helu33/25-aiming-cart/docs/CHASSIS_SCHEME.md

# 底盘方案（2025 电赛 E 题，正方形巡线）

本文是开发前写的底盘设计方案，记录设计思路和取舍。底盘负责巡线、过弯、计圈和停车，并把运动状态发给云台。实现时不少细节改了（例如直道加了陀螺航向保持、丢线不做原地搜索、参数都按实车重新标定），**现行实现、参数和接线以 [chassis/AUTONOMOUS_CHASSIS.md](../chassis/AUTONOMOUS_CHASSIS.md) 和源码为准**。云台和 K230 视觉见 [GIMBAL_COMM_PROTOCOL.md](GIMBAL_COMM_PROTOCOL.md) 和 [K230_VISION_SCHEME.md](K230_VISION_SCHEME.md)。

底盘用 STM32F103，代码基础是作者自己的 ROS 2 小车固件，沿用其中的 8 路选通式巡线模块、电机、车轮和编码器；没有按赛题要求移植到 TI MSPM0。硬件层与控制层分离，控制层可以在电脑上测试。

## 0. 赛题约束

赛题摘录，完整条款以原题为准。本项目用 STM32 代替 MSPM0，不满足「控制器」一条。

来源：[2025 年 E 题 简易自行瞄准装置](https://nuedc.org/problems/2025_E%E9%A2%98_%E7%AE%80%E6%98%93%E8%87%AA%E8%A1%8C%E7%9E%84%E5%87%86%E8%A3%85%E7%BD%AE.pdf)。

| 项目 | 要求 |
|---|---|
| 赛道 | 白色哑光场地上的黑色边线，线宽 1.8 cm ± 0.2 cm；外沿 100 cm × 100 cm 正方形，顶点 A、B、C、D |
| 方向 | 逆时针行驶，因此每个拐角都是**左转** |
| 基本 (1) | 圈数 N 可在 1～5 之间设定，每次 t ≤ 20 s；瞄准模块电源断开，底盘必须能独立运行 |
| 发挥 (1)(2) | 小车放在 AB 段，前沿投影与 AC 线对齐；N=1 时 t ≤ 20 s，N=2 时 t ≤ 40 s；全程激光连续打靶，D1 ≤ 2 cm |
| 发挥 (3) | N=1，t ≤ 20 s，激光同步画半径 6 cm 的圆；车跑 1 圈正好画 1 圈，同步误差小于 1/4 圈 |
| 车体 | 不大于 25 cm（长）× 15 cm（宽）× 25 cm（高），含云台；3～4 个轮，不得用履带和麦轮 |
| 轨迹 | 行驶中小车投影必须在轨迹线上，投影完全脱离轨迹线即本项失败 |
| 控制器 | 巡迹和电机控制必须由 TI MSPM0 完成，控制板裸露在表面；MSPM0 与瞄准模块各用独立电源开关，并用发光管显示供电状态 |
| 干预 | 行驶中不得人为干涉或遥控；进入测试后中途不得更换电池 |

## 1. 总体思路

- 两轮差速，**全程不停车**。直线巡线，拐角走一段小半径圆弧，圆弧结束后重新压上黑线。
- 平滑靠三件事：线速度和角速度都限加速度；转弯时角速度按斜坡升降，曲率连续变化；直线段巡线增益随速度降低，不来回摆头。
- 传感器分工：
  - 8 路灰度：横向偏差和拐角检测；
  - 编码器：轮速闭环和沿边行驶距离；
  - ICM-40607：只用来判断这一个弯转了多少度。
- 每个弯单独从 0° 开始计角度，直线由黑线纠正航向，陀螺仪漂移不会跨弯累积。

## 2. 硬件

| 部分 | 当前方案 |
|---|---|
| 主控 | STM32F103RCT6，72 MHz |
| 电机驱动 | TB6612 双路，双 PWM 输入，约 80 kHz：左 PA0/PA1（TIM2），右 PA6/PA7（TIM3） |
| 编码器 | 左 PB6/PB7（TIM4），右 PC6/PC7（TIM8）；13 线 × 30 减速 × 4 倍频 = 每轮 1560 count |
| 车轮 | 沿用旧轮组；实测轮距 0.115 m，左右轮周长分别标定（见 `chassis/AUTONOMOUS_CHASSIS.md`） |
| IMU | ICM-40607，I2C2：PB10 SCL、PB11 SDA，地址 0x68，WHO_AM_I 为 0x38 |
| 巡线 | PC0=AD0、PC1=AD1、PC2=AD2、PB0=OUT；沿用旧模块，装在车头横向居中 |
| 到云台 | USART2：PA2 TX 接云台板 USART1 的 PA10 RX（丝印 USART1 的 3 针口），云台 PA9 TX 回到 PA3 RX（`$G`），921600 8N1，必须共地。`CHASSIS_GIMBAL_UART` 可改回 4（UART4 PC10/PC11）；用 USART2 时调试口必须在 UART5 |
| 人机 | PB5 模式按键（打靶心 ↔ 画圆）+ PB1 蜂鸣器；RGB 灯显示状态。原计划的 3 个按键（圈数、任务、启动）没有接 |

灰度模块要求：

- 8 路探头总宽 8～10 cm，相邻间距约 1.2～1.4 cm。1.8 cm 线宽时，直线上同时压到 1～2 路。
- 探头离地按模块说明调好，在白色场地和黑线上分别看到稳定的 0/1。
- **探头到驱动轮轴的前后距离 `d_s`** 直接决定过弯起点，建议 10～12 cm，安装后量准写入参数。
- 已确认采用旧工程选通接口：3 个 GPIO 输出地址、1 个 GPIO 输入 OUT；旧驱动约定黑线为高、ch0～7 从左到右。移植后验证极性和顺序，不照抄 RA4M2 的引脚编号。
- 旧驱动每路选通等待 500 µs，完整 8 路扫描至少 4 ms；先保留稳定时间，不能按原先 2 ms 完整扫描实现。

## 3. 软件结构

按两层划分，第二层不含任何 HAL、寄存器、中断代码，可在电脑上单元测试。现有应用层与 BSP 的依赖需要适配，不能认为复制文件后就已完成分层。

```text
硬件层（换 MCU 时重写）
  bsp_motor     左右 PWM，正负占空比
  bsp_encoder   计数增量与轮速
  bsp_imu       ICM-40607 初始化、零偏校准、读取 gz
  bsp_line      读 8 路灰度，返回 8 位掩码（bit=1 表示黑线）
  bsp_uart_gb   发给云台的串口
  bsp_key_led   按键、LED

控制层（纯 C，与芯片无关）
  wheel_speed   轮速前馈 + PI，每轮独立            ← 复用 app_motor.c
  diff_drive    (v, w) → 左右轮目标速度            ← 复用 app_motor_set_chassis_velocity
  line_sensor   掩码 → 横向偏差、拐角、丢线判断
  line_follow   偏差 → 角速度 w
  turn_profile  圆弧过弯：v、w 曲线与退出判断
  mission       状态机：起步、巡线、过弯、计圈、停车
  chassis_link  组 $C 帧（复用 examples/chassis_protocol.c）
```

`ros_stm32` 里可直接复用的部分：轮速前馈和 PID、速度低通、差速换算和轮速限幅、起步死区补偿、编码器测速、陀螺零偏校准与静止零偏学习、IWDG 看门狗、10 ms 调度框架。原来的 USART2 速度命令入口保留（`CHASSIS_AUTONOMOUS_ENABLE=0`），比赛流程不用。

## 4. 控制周期

| 周期 | 内容 |
|---|---|
| 10 ms（初始安排） | 完成一次 8 路灰度扫描，最近 3 次完整扫描做多数表决；旧驱动等待累计至少 4 ms，需实测整个控制周期预算，必要时改为非阻塞扫描 |
| 10 ms | 读编码器和 ICM-40607 → 更新距离和本弯转角 → 状态机 → 算 (v, w) → 加速度限幅 → 差速换算 → 轮速 PI → PWM |
| 20 ms | 给云台发一帧 `$C` |

控制循环用实际测得的 dt，限定在 5～30 ms。一次循环超时就记故障，不跳过轮速环。

## 5. 轮速环

沿用 `app_motor.c`：前馈占空比 = 死区补偿 + 目标速度 / 满占空比速度，再加 PI 修正，测速做 50 ms 一阶低通。

同款电机、轮组和编码器先沿用现有标定参数；装配和负载改变后复核以下三件事，再决定是否重新标定：

1. 架空，按 20%、40%、60%、80% 占空比测稳定轮速，拟合每侧的满占空比速度和死区。
2. 落地做 0 → 0.3 m/s 阶跃，看上升时间和超调，调 Kp、Ki。目标：上升时间约 100 ms，无明显超调，两轮响应接近。
3. 用 0.1 m/s 低速直行，确认低速不会一顿一顿。过弯时内侧轮可能低到 0.1 m/s 左右，这个速度必须平稳。

## 6. 巡线偏差

探头编号 0～7 从左到右，中心位置 `x_i = (i - 3.5) × 探头间距`，左负右正，单位 mm。

```text
blacks = 掩码中为 1 的路数
e_raw  = Σ x_i（黑） / blacks           blacks 在 1～3 时有效
e      = 一阶低通(e_raw)，时间常数约 20 ms
de     = (e - e_prev) / dt，再做一次低通
```

| 现象 | 判断 |
|---|---|
| blacks 在 1～3，且黑点连续 | 正常巡线 |
| blacks = 0 | 暂时丢线，进入第 9 节的找线处理 |
| blacks ≥ 4，或最左两路之一与中间同时为黑 | 拐角候选，见第 7 节 |
| 黑点不连续（中间夹白） | 本次读数丢弃，沿用上一次 e |

## 7. 拐角检测

逆时针行驶时，黑线在拐角处向左延伸，所以拐角特征是**左半边连续多路变黑**。

同时满足以下条件才判为拐角：

1. 左侧 0～3 路中至少 3 路为黑，且黑点与中线相连；
2. 连续 3 次完整扫描都满足；按初始 10 ms 扫描周期，保守按约 30 ms 确认预算（0.4 m/s 下约 12 mm）计入转弯触发距离，不能继续按原先 6 ms 计算；
3. 本条边已行驶距离 ≥ 0.50 m（编码器平均距离，从上一个弯退出时清零）。起步后第一条边不检查这一条，因为起点位置不固定。

第 3 条用来挡住圆弧出弯时传感器扫过黑线造成的误判，以及偶发的污渍误判。

## 8. 圆弧过弯

### 8.1 几何

拐角检测到时，探头在拐角处，驱动轮轴还在拐角前 `d_s`。车体中心走半径为 R 的四分之一圆弧，弧的起点应在轴到达拐角前 R 处，所以：

```text
检测到拐角后，再直行 max(0, d_s - R) 才开始转。
```

取 `R ≈ d_s` 时检测到就能立即开始转，最简单。R 不要大于 d_s，否则检测到时已经晚了。

R 取 0.10～0.13 m 时，车体中心离拐角顶点最近约 4～5 cm。车宽 15 cm，车身投影一直压在黑线上，满足投影规则。

### 8.2 速度曲线

进弯前把 v 从直线速度降到过弯速度 `v_turn`。降速可以在弯前提前开始：第一条边结束后已知边长，从第二条边起，在走到边长减 0.15 m 时就开始减速。

进入圆弧后 v 保持 `v_turn`，角速度按三段走：

```text
w_max = v_turn / R
升：0 → w_max，时长 t_r（约 0.12 s）
平：保持 w_max
降：w_max → 0，时长 t_r
```

降速段开始点用陀螺仪角度判断：本弯已转角度 `Δψ ≥ 90° - w_max × t_r / 2 × 180/π`。升降两段的角度之和就是这个修正量。

### 8.3 回到巡线

满足以下任意一组条件，就退出过弯，回到巡线：

- `Δψ ≥ 75°`，且中间 3、4 两路至少一路为黑，并且 blacks 在 1～3；
- `Δψ ≥ 90°` 后再走 3 cm，且有任意一路为黑。

如果 `Δψ ≥ 105°` 还找不到线，进入找线处理。

退出时把巡线 PD 的历史量清零，v 再按加速度限幅升回直线速度。90° 只是参考，弯的最后几度由巡线自己补正，所以不要求陀螺仪转角精确到 1°。

## 9. 巡线控制

```text
w = -(Kp(v) × e + Kd × de)
Kp(v) = Kp0 × v_ref / max(v, 0.1)       速度越高，同样偏差给的 w 越小，避免高速摆头
v_cmd = v_set × (1 - k_slow × min(|e| / e_max, 1))
```

- 偏差大时自动降一点速度，`k_slow` 约 0.3。
- w 加角加速度限幅，约 6 rad/s²。v 加线加速度限幅，加速约 0.8 m/s²，减速约 1.2 m/s²。
- 直线上不叠加陀螺仪航向保持。黑线本身就是航向参考，两个参考同时存在会互相打架。（实现时改了：实车出弯后车头残留偏角，摆动要约 2 s 才收敛，所以直道加了航向保持 `CHASSIS_LINE_KH` 和陀螺角速度环 `CHASSIS_YAW_RATE_KG`。）

**丢线找线：** blacks = 0 时，先按最后一次 e 的方向，以当前 w 继续走最多 0.3 s 或 8 cm，同时把 v 降到 0.15 m/s。仍未找回，就原地慢转 ±20° 搜索。再找不到，就停车并亮故障灯。（实现：全丢时朝最后看到线的一侧以 1.0 rad/s 低速转向，0.20 s 内找不回就停车，不做原地搜索。）

## 10. 状态机

| 状态 | 动作 | 离开条件 |
|---|---|---|
| `IDLE` | 电机停止；按键设置圈数 N、任务号；LED 显示 | 按启动键 |
| `CALIB` | 静止 2 s 校准陀螺零偏；必须保持车不动 | 校准完成 |
| `START` | v 从 0 升到直线速度，进入巡线 | 速度到达 |
| `LINE` | 巡线；累计本边距离 | 检测到拐角 → `PRE_TURN` |
| `PRE_TURN` | 继续巡线并减速，再走 `max(0, d_s - R)` | 距离到 → `TURN` |
| `TURN` | 按 8.2 的曲线过弯 | 8.3 条件满足 → `LINE`，拐角数加 1 |
| `FINISH` | 拐角数达到 4N 后，再走第 11 节的停车距离，然后减速到 0 | 速度为 0 → `STOP` |
| `STOP` | 电机刹停，PID 清零 | 回到 `IDLE` |
| `FAULT` | 刹停，LED 报故障码 | 手动复位 |

当前实现从 `PRE_TURN` 开始发 `mode=1`，保持到 `REACQUIRE` 完成；回到 `LINE/FINISH` 后发 0。FAULT 也请求保持（1）。预告至少 60 ms，但没有远端 ACK。

## 11. 计圈与停车

- 起点在某条边上，离下一个拐角的距离未知。用编码器记下起点到第一个弯的距离 `d_first`。
- 跑完第一圈时，用实测平均边长 `L_edge`（拐角到拐角）计算停车距离：

```text
d_stop = L_edge - d_first
```

- 拐角数达到 4N 后，再走 `d_stop` 就到起点，开始减速停车。
- 时间检查：从启动起计时，若接近题目限时仍未完成，不改变行为，只把实际用时记下来供调参。

## 12. 速度与时间预算

按轨迹中心线算，每边 0.982 m（外沿 100 cm 减去一个线宽）。

| 参数 | 基本 (1) | 发挥 (1)(2) | 发挥 (3) |
|---|---|---|---|
| 直线速度 | 0.45 m/s | 0.30 m/s | 0.25 m/s |
| 过弯速度 `v_turn` | 0.25 m/s | 0.20 m/s | 0.20 m/s |
| 转弯半径 R | 0.10 m | 0.12 m | 0.12 m |
| 过弯角速度峰值 | 2.5 rad/s | 1.7 rad/s | 1.7 rad/s |
| 估算一圈 | 约 10 s | 约 14 s | 约 16 s |

- 基本 (1) 云台断电，跑快一点，给 20 s 的限制留余量。
- 发挥题跑慢一点。过弯角速度就是云台必须反向补偿的速度，越小越好打靶。
- 发挥 (3) 要求一圈时间稳定，方便云台按进度画圆。时间预算留 4 s 余量。
- 内侧轮最低速度为 `v_turn - w × 0.061`。表中各组都约 0.1 m/s，这是第 5 节低速平稳测试必须覆盖的下限；低速发抖时增大 R 或 `v_turn`，不要取消斜坡。

## 13. ICM-40607

- 接 I2C2：PB10 为 SCL，PB11 为 SDA，7 位地址 0x68。配置为 100 Hz、陀螺仪 ±500 °/s、加速度 ±4 g。WHO_AM_I 应为 0x38。
- 上电或每次启动前静止 2 s 校准零偏。沿用现有的静止判断：编码器 200 ms 无增量、且 |gz| 很小时，在线更新剩余零偏。
- 本弯转角 `Δψ = ∫ gz dt`，进入 `TURN` 时清零。
- 给云台的航向 `yaw` 用全程积分值，CCW 为正，归一化到 ±180°。只作参考，不要求绝对准确。
- 轴向沿用原工程：传感器 Y 作为车体 X，传感器 X 取反作为车体 Y，传感器 Z 作为车体 Z。装车方向变了再改 `BOARD_IMU_AXIS_*`。
- 实现：IMU 连续无效超过 50 ms 报故障停车（期间用编码器差速估算角速度），不降级到编码器跑完本圈。

## 14. 与云台的配合

底盘每 20 ms 发一帧 `$C`（现在是版本 3），格式和编码函数见 [GIMBAL_COMM_PROTOCOL.md](GIMBAL_COMM_PROTOCOL.md) 第 4 节和 `docs/examples/chassis_protocol.c`：

```text
$C,3,seq,mode,imu_valid,yaw,pitch,roll,gx,gy,gz,speed_mm_s,task,progress*CRC16\n
```

- `mode=1` 在 `PRE_TURN/TURN/REACQUIRE/FAULT` 状态发送，其余状态发 0。
- 云台看到 `mode=1` 时暂停视觉、保持当前世界方向。回到 `mode=0` 后，云台等到新的有效视觉帧再跟踪。
- 底盘停发超过 300 ms，云台认为底盘掉线并冻结视觉。所以停车后也要持续发心跳。
- 底盘只测 gz：IMU 正常时 `imu_valid=1`、填入 gz，yaw/pitch/roll/gx/gy 填 0。
- `speed_mm_s` 是编码器测得的前进速度，云台用作车速前馈；gz 只有打开 `tune_yaw_two_loop` 时才作为转速前馈。
- **画圆（发挥 (3)）**：`task`=1 表示画圆，`progress` 是本次跑圈进度（千分之一圈，已走距离 ÷ 4 倍拐角触发间距）。云台把它转发给 K230，K230 按进度选取圆上的目标点。同步误差要求小于 1/4 圈，按距离计算的进度足够。
- 反方向，云台以 10 Hz 发 `$G` 就绪状态（第 4.1 节），底盘上电自启动要等它。
- 云台 yaw 不限位（`GIMBAL_YAW_LIMIT_ENABLE 0`），可以跟着车连续转。

## 15. 故障与安全

| 故障 | 处理 |
|---|---|
| 丢线找不回 | 停车，LED 报故障 |
| 拐角后 `Δψ ≥ 105°` 仍无线 | 进入找线；失败则停车 |
| 编码器一侧长期无增量而另一侧有 | 判为打滑或断线，停车 |
| 控制循环超时 | 记录故障；连续超时则停车 |
| 主循环卡死 | IWDG 约 1 s 复位，上电默认停车 |
| IMU 读失败 | 用编码器差估角，降速完成本圈 |
| 电池电压低（如有 ADC） | 启动前提示，避免中途速度不够 |

实现的故障码见 `chassis/AUTONOMOUS_CHASSIS.md` 的 fault 表。

## 16. 参数初值

设计时的初值；现行值见 `chassis/AUTONOMOUS_CHASSIS.md` 的「默认参数」。

| 参数 | 初值 | 说明 |
|---|---|---|
| 控制周期 | 10 ms | 灰度先每周期完整扫描一次；实测预算，必要时改非阻塞扫描 |
| 线加速度 | +0.8 / −1.2 m/s² | 限幅 |
| 角加速度 | 6 rad/s² | 限幅 |
| 巡线 Kp0 | 0.02 rad/s/mm（v_ref=0.3 m/s） | 实测调整 |
| 巡线 Kd | 0.002 rad/s/(mm/s) | 实测调整 |
| 偏差低通 | 20 ms | |
| 拐角确认 | 3 次连续采样 | |
| 拐角最短边距 | 0.50 m | 首边不检查 |
| `d_s` | 实测 | 探头到轮轴前后距离 |
| R | 0.10～0.12 m | ≤ d_s |
| `t_r` | 0.12 s | 角速度升降时间 |
| 退出过弯 | Δψ ≥ 75° 且中线见黑 | |
| 丢线容忍 | 0.3 s 或 8 cm | |

## 17. 调试与验收顺序

1. **架空**：电机正反转、停止；编码器正方向；每轮一圈约 1560 count。
2. **ICM-40607**：WHO_AM_I 为 0x38；静止 gz 接近 0；手转车 90°，积分角在 90° ± 2°。
3. **灰度**：手推车过黑线，8 位掩码和偏差符号正确；拐角处左侧多路变黑。
4. **轮速环**：第 5 节的标定和阶跃。
5. **直线巡线**：只跑一条边，0.2 → 0.45 m/s 逐步提速，看偏差是否平稳收敛。
6. **单个弯**：在一个角来回测试，调 R、`v_turn`、退出条件，确认车身投影不离线。
7. **整圈**：N=1～5，记录每圈时间、停车位置误差和拐角漏判/误判次数。
8. **和云台联调**：确认 PRE_TURN/TURN/REACQUIRE/FAULT 的 mode=1、其余为 0，20 ms 心跳稳定；本地发送正常时云台断电不阻止底盘独立运行。
9. **整车复测**：重复验证连续多圈、供电、失线停车和通信恢复。
