helu33/25-aiming-cart/docs/K230_VISION_SCHEME.md

# K230 视觉方案说明

本文给后续在 K230 上实现视觉的开发使用。云台控制板是执行器，K230 是瞄准计算端。K230 只报告“预测激光落点还要转多少角度才能打到靶心”，不发电机指令，也不改云台固件。

协议的完整收发规则以 `docs/GIMBAL_COMM_PROTOCOL.md` 和当前固件为准。本文只固定 K230 必须遵守的那一部分，并写明视觉算法怎么接到这个接口上。

## 0. 已确认条件与当前阶段（2026-10-17）

以下为用户已确认的实物和场地条件，优先于后文的原方案假设：

| 项目 | 当前条件 |
|---|---|
| 靶纸方向、外框尺寸 | A4 横放，宽 297 mm、高 210 mm；透视变换按此外框尺寸建立靶平面 |
| 黑胶带宽度 | 四边向内各占 18 mm |
| 内框尺寸 | 宽 261 mm、高 174 mm |
| 靶心 | 已确认与内外框共同的几何中心重合 |
| 开发板 | 亚博 K230 视觉识别模块（Yahboom K230 Vision Module），课程页对应板型 |
| 摄像头 | 板载 200 万像素 GC2093 |
| 屏幕 | 当前按未接显示屏规划，默认无屏运行，不初始化物理屏幕；无屏媒体初始化细节待实际固件核对 |
| 软件接口 | 亚博例程的 `media.sensor.Sensor` / `Sensor()`，RGB565 采图，图像处理使用配套固件中的 `import cv2` |
| 固件版本状态 | 课程配套版本名已知，板上当前烧录版本尚未通过 CanMV IDE 读取确认 |
| 相机与激光安装 | 一同固定在 Pitch 输出平台，相对上下间距 18 mm；沿用原方案相机在激光下方的布局，光心/出光轴间距需实物复核 |
| 场地 | 轨迹外沿为 1000 mm × 1000 mm 正方形；靶面竖在 AB 外侧 500 mm，并与 AB 平行 |
| 距离 | 车靠 AB 时到靶平面垂距约 500 mm，靠 CD 时约 1500 mm；斜视时的视线距离另算 |
| 倾斜 | 用户描述可能小于约 60°；夹角定义与实际覆盖范围待实测，不能全部当成近正视处理 |
| 光斑要求 | 靶上光斑直径 ≤5 mm，与瞄准偏差分开检查 |
| 靶心瞄准评分 | 光斑痕迹离靶心最大距离 D1≤20 mm 为满分 |
| 后续画圆评分 | 靶面圆弧半径 60 mm；痕迹离圆弧最大距离 D2≤20 mm 为满分 |
| 扣分规则 | D1/D2 每超过 20 mm 再增加 10 mm 扣 1 分，不足 10 mm 按 10 mm 计 |
| 当前阶段 | 先完成靶心瞄准；画圆保留后续扩展，不作为本阶段验收项 |
| 标定状态 | 尚无实际激光落点标定数据，后续必须补齐，不能把预测落点当作已验证 |

靶心已确认与外框几何中心重合。靶平面原点取外框左上角、x 向右、y 向下，靶心坐标固定为 **(148.5, 105.0) mm**；它是靶平面物理坐标，不是任意分辨率下的图像像素坐标。

理想内外框物理面积比为 `(261×174)/(297×210)≈0.72814`。它可辅助检查靶框候选，但不是未经测试就固定的 `MIN_AREA_RATIO`；原图透视、胶带贴合和轮廓提取会影响测量值。

**几何模型尚有待确认项：** 误差在透视校正图中计算这一点已确认；但激光预测点必须响应本帧靶框位置和姿态。不能直接把“校正图固定 x、y 只随距离变化”当成已经成立的模型，否则同距离下横向移动靶框时可能失去相应误差变化。后文相关步骤均按此待办理解。

## 1. 分工

| 端 | 职责 |
|---|---|
| K230 | 识别矩形靶，逆透视拉正，估计靶面距离与姿态，预测激光落点，把落点相对靶心的偏差换成角度，从 UART 周期发出；面积测距仅作近正视初估 |
| 云台板 `gimbal/App/gimbal_task.c` | 把收到的角度加到当前 IMU 姿态上，得到目标角；以 500 Hz 计算并下发电机速度指令。死区、方向、动态增益、限位、底盘转弯暂停都在这里 |

云台每帧按下面的方式使用视觉角度，误差是当前这一帧的绝对偏差，不是相对上一帧的增量：

```c
g_world_target_yaw = imu_yaw_current + yaw_err_deg * VISION_YAW_DIR * dynamic_gain;
g_world_target_pitch = imu_pitch_current + pitch_err_deg * VISION_PITCH_DIR * dynamic_gain;
```

`VISION_YAW_DIR` 当前为 `-1`，`VISION_PITCH_DIR` 当前为 `+1`。这两个系数只放在云台里。K230 不要再取反。

`valid=0` 时不再用视觉更新目标，云台进入现有无目标控制分支：Yaw 沿用已有目标并受静止重设逻辑影响；正常巡线时 Pitch 使用启动基准补偿，不保证保持最后视觉姿态。转弯及恢复等待期间使用各自的保持分支。超过 300 ms 没有被接受的新视觉帧，跟踪退出。上电后前 5 秒 USART10 上的视觉帧被丢弃，序号在这 5 秒内也不消耗，5 秒后的第一帧可以从任意序号开始。

`gimbal/App/gimbal_task.c` 里的 `VISION_YAW_OFFSET_PIXELS`（现为 15）和 `VISION_PITCH_OFFSET_PIXELS`（现为 0）没有参与控制运算。K230 不要为了这两个宏去挪瞄准点。

## 2. 硬件连接

K230 资料页：<https://www.yahboom.com/study/K230>

运行环境是 CanMV MicroPython，不是桌面 CPython。`docs/examples/vision_protocol.py` 只是组帧参考，不能作为 K230 主程序。

本方案的硬件基线是 **亚博 K230 视觉识别模块 + 板载 GC2093**。根据用户最新说明，当前按未接显示屏规划，瞄准结果从 UART 发出，主流程不依赖物理屏幕。采图按亚博例程使用 `media.sensor.Sensor` 的 `Sensor()` 路径，输出 RGB565。默认不初始化 `Display.ST7701`；若实际固件的媒体初始化需要虚拟显示目标，应先核对配套无屏例程和实机行为，不能据此假定所有固件都需要 `Display.VIRT`。模糊、Canny、轮廓和透视变换按配套固件的 `import cv2` 接口实现。不要套用 01Studio CanMV K230 开发板的 CSI 扩展相机初始化方式。

固件信息按用户提供的课程说明记录，须区分以下三项：

| 信息 | 当前含义 |
|---|---|
| `CanMV_K230_YAHBOOM_micropython_v1.8-13` | 亚博 OpenCV 专题注明的配套固件版本，作为接口核对参考 |
| `CanMV_K230_YAHBOOM_micropython_local_nncase_v2.9.0.img` | 2025 年烧录教程示例镜像文件名，不据此认定板上当前版本或 MicroPython/OpenCV 版本 |
| 板上实际版本 | 尚未读取；以 CanMV IDE 连接后显示的版本为准，并在首次运行记录中保存 |

实现前需用实际板确认 RGB565 图像到该固件 `cv2` 输入的转换方式、尺寸和通道布局，不默认桌面 OpenCV 的三通道 BGR 数组接口可直接套用。

USB 口旁边的 4 针通讯口默认是 UART1：

| K230 丝印 | SoC 引脚 | 功能 | 接到云台 |
|---|---|---|---|
| 3 | GPIO9 | UART1_TXD | USART10 RX，PE2 |
| 4 | GPIO10 | UART1_RXD | 协议无回传，可以先不接。若接，则接 PE3 |
| 2 | GND | 地 | 与云台共地 |
| 1 | 5V | 电源 | 不作为串口电平 |

电平是 3.3 V TTL。云台 USART10 在 `Core/Src/usart.c` 中配置为 921600、8 数据位、无校验、1 停止位、无流控。

亚博教程里的 UART1 初始化：

```python
fpioa.set_function(9, fpioa.UART1_TXD, ie=0, oe=1)
fpioa.set_function(10, fpioa.UART1_RXD, ie=1, oe=0)
uart = UART(UART.UART1, baudrate=921600,
            bits=UART.EIGHTBITS, parity=UART.PARITY_NONE, stop=UART.STOPBITS_ONE)
```

Zadig（`zadig-2.9.exe`）只用于电脑给 K230 烧录固件时的 USB Boot 驱动，和云台这路 UART 无关。烧录说明在教程「1.快速入门 / 1. K230固件下载与烧录」。

## 3. 串口帧

只发视觉帧，发到 UART1。不要发底盘用的 `$C` 帧。

```text
$V,1,seq,valid,yaw_error_deg,pitch_error_deg*CRC16\n
```

| 字段 | 规则 |
|---|---|
| `seq` | 每个新处理结果加 1，uint16 回绕。丢失目标的帧也要加 1 |
| `valid` | 字符 `1` 或 `0`。没有合格靶框时为 `0`，两个角度填 `0.000` |
| 两个角度 | 十进制，建议固定 3 位小数。单位是度，范围 [-180, 180]。超过 180 的帧会被云台拒绝 |
| CRC | CRC-16/CCITT-FALSE：多项式 `0x1021`，初值 `0xFFFF`，不反射，结果异或 `0x0000`。只覆盖 `$` 与 `*` 之间的 ASCII 正文。输出 4 位大写十六进制 |

标准帧，实现后必须逐字节一致：

```text
$V,1,1,1,2.500,-1.000*3C12
$V,1,2,0,0.000,0.000*A424
```

校验向量：正文 `123456789` 的 CRC 为 `29B1`。

符号，在换算完成、尚未被云台乘 `VISION_*_DIR` 之前：

- 靶心在预测激光落点右侧：`yaw_error_deg > 0`
- 靶心在预测激光落点下方：`pitch_error_deg > 0`

方向反了只改云台的 `VISION_YAW_DIR` 或 `VISION_PITCH_DIR`，不要在 K230 上叠第二层取反。

发送节奏：每得到一帧新图像就发一帧。K230 上稳定十几到几十赫兹即可。不要把同一张旧图重复编成新序号。算法停住时不要继续发上一帧的有效角度。云台队列只有 7 帧，队满丢新帧。

## 4. 为什么先算毫米再换成角度

相机装在激光下方，两者不共轴。只把图像中心当成瞄准点时，距离一变，激光落点会在垂直方向错开。

视觉内部可以沿用矩形靶方案：在拉正后的靶平面上用毫米表示“预测落点到靶心”的偏差。出串口之前必须换成角度，因为云台把收到的数直接加到 IMU 角度上。1 m 处 1° 大约是 17 mm；若把 17 当角度发出去，云台会去追大约 17°。绝对值大于 180 的毫米数还会被整帧丢弃。

```text
yaw_error_deg   = atan2(err_x_mm, distance_mm) * 180 / π
pitch_error_deg = atan2(err_y_mm, distance_mm) * 180 / π
```

`err_x_mm`、`err_y_mm` 使用第 3 节的符号：靶心在落点右侧、下方时为正。对准时两个误差都是 0，毫米零点和角度零点相同。

上式是近正视、小修正时的近似，不能把场地的 500～1500 mm 垂距直接当成任意姿态下的 `distance_mm`。较大倾斜时需明确相机到靶面的几何关系，再求电机对应的角度修正；透视校正后的毫米轴也不必然直接对应云台 Yaw/Pitch 轴。

## 5. K230 上的视觉算法

算法来自矩形靶逆透视打靶方案，采图和出串口改成 K230 与本仓库协议。不要移植海康威视 SDK。

处理上限不必追求原方案的 90–100 Hz。先保证帧是新的、角度单位正确。

1. **采图。** 使用亚博 GC2093 例程的 `media.sensor.Sensor` / `Sensor()`，输出 RGB565。首次按 640×480 进行接口和精度检查，处理速度不足时可降到 320×240。分辨率变更后同步更新坐标比例及对应标定。不要使用海康 SDK 或 01Studio CSI 扩展写法；实际固件版本按第 2 节核对。
2. **预处理。** `import cv2`。灰度、高斯模糊、`THRESH_BINARY_INV`、闭运算补断边，同时做 Canny。二值图与边缘图按位或后 `findContours`。亚博文档确认 K230 的 `cv2` 包含色彩转换、几何变换、阈值、滤波、边缘、形态学和轮廓；典型链路就是 `cvtColor → GaussianBlur → Canny → findContours`。
3. **确认靶纸。** 找嵌套的父子轮廓，同时检查子/父面积比及内框四角在外框透视映射中的位置。优先选取时间连续、面积较大的合格候选，连续 3 帧确认。当前实现没有合格内外框时发送 `valid=0`，不将普通外接矩形退化结果用于控制，防止误跟随背景矩形。外框四角按固定顺序排列。
4. **拉正。** 用外框四角和 297 mm × 210 mm 的物理尺寸做透视坐标变换。当前板端只变换坐标并求姿态，不生成整张拉正图，减少开销；电脑 `vision/tools/inspect_frame.py` 可输出 2 px/mm 的拉正预览。内框 261 mm × 174 mm 用于辅助验证；靶心取靶平面几何中心 (148.5, 105.0) mm。
5. **测距。** 原方案使用原图外框面积，不依赖激光亮点：

   ```text
   distance_mm = REFERENCE_DISTANCE_MM * sqrt(REFERENCE_AREA_PIXELS / outer_area_pixels)
   ```

   `REFERENCE_DISTANCE_MM` 和 `REFERENCE_AREA_PIXELS` 必须在已知距离下实测量，不能沿用别的项目的数。该公式仅作为近正视初始估计；倾斜会改变投影面积。当前 `vision/geometry.py` 已选用相机内参、畸变和实际外框尺寸求平面姿态，不使用面积测距公式，因而此版本不需要这两个面积测距参数。不能使用拉正后固定大小的输出图面积测距。
6. **预测激光落点。** 已确认相机和激光一同固定，上下相差约 18 mm，但此间距不能替代出光方向及相机参数标定。运行时仍按预测落点瞄准，不要求实时检测光斑；标定阶段允许人工观察/测量实际光斑。最终误差在校正图计算，但预测点必须随本帧透视映射/靶平面姿态更新。原先“校正图 x 固定、y 只随距离插值”的描述保留为待核验假设，不可直接用于最终跟踪闭环。
7. **偏差。** 在校正图平面上计算靶心相对该预测落点的 `err_x_mm`、`err_y_mm`，再按第 4 节换成角度。
8. **发送。** `uart.write(encode_vision(seq, True, yaw_deg, pitch_deg))`，然后 `seq = (seq + 1) & 0xFFFF`。无靶时 `encode_vision(seq, False)`。
9. **调试输出。** 默认无屏运行，主循环关闭画框和显示输出；使用限频日志记录帧率、目标有效性、距离估计和角度误差。需要临时看图时再核对实际固件的 IDE 预览接口，调试结束后关闭。USB 图像传输会引入额外开销，不能拿 IDE 画面刷新率当算法速度；实际耗时用板上计时。

组帧函数与 `docs/examples/vision_protocol.py` 同一合同，下面这份不依赖桌面 CPython 的 f-string 以外的库，可放进 K230 脚本：

```python
import math

def crc16_ccitt_false(data):
    crc = 0xFFFF
    for value in data:
        crc ^= value << 8
        for _ in range(8):
            crc = ((crc << 1) ^ (0x1021 if crc & 0x8000 else 0)) & 0xFFFF
    return crc

def encode_vision(seq, valid, yaw_error_deg=0.0, pitch_error_deg=0.0):
    if not isinstance(seq, int) or not 0 <= seq <= 65535:
        raise ValueError("seq")
    if not valid:
        yaw_error_deg = pitch_error_deg = 0.0
    if any((not math.isfinite(v)) or abs(v) > 180 for v in (yaw_error_deg, pitch_error_deg)):
        raise ValueError("angle")
    body = "V,1,{:d},{:d},{:.3f},{:.3f}".format(
        seq, 1 if valid else 0, yaw_error_deg, pitch_error_deg).encode("ascii")
    return b"$" + body + "*{:04X}\n".format(crc16_ccitt_false(body)).encode("ascii")
```

若当前固件的 `math` 没有 `isfinite`，用有限且绝对值不超过 180 的判断替换。

只找色块、把图像中心当瞄准点时，可以用 `cv_lite` 或 `img.find_blobs()`。那条路径没有补偿相机和激光的视差，距离变化后激光会偏。矩形靶方案才是本文要落地的路径。`cv_lite` 适合作为“板子和串口是否通”的短实验，不作为最终瞄准算法。

## 6. 必须实标的量

| 量 | 含义 |
|---|---|
| 靶纸外框的物理宽高 | 已确认为 297 mm × 210 mm，内框 261 mm × 174 mm；需核对实际贴边 |
| `MIN_AREA_RATIO` | 内框面积 / 外框面积的下限 |
| `REFERENCE_DISTANCE_MM`、`REFERENCE_AREA_PIXELS` | 原面积测距方案参数；当前姿态求解版本不使用 |
| 相机与激光相对位置/方向 | 上下间距已知约 18 mm，左右偏移、光轴夹角和光心定义仍需核对 |
| 激光实际落点数据 | 待实测；每组记录距离定义、靶框四角、图像分辨率、靶面倾斜和实际落点 |
| 预测点到校正图的映射 | 需验证固定距离下靶框横移/倾斜时，落点和误差仍正确变化 |
| 相机内参与畸变 | 尚未提供，用于较大斜视下的几何修正；与相机型号、镜头、分辨率绑定 |

检测分辨率、裁剪方式、镜头或相机/激光相对安装一旦改变，应重新检查对应标定。角度换算模型需覆盖实际斜视范围，不能假定始终使用近正视公式。

### 标定提醒与完成条件

**提醒事项：进入落点预测实现验收或首次带激光的闭环联调前，先提醒用户补齐实际落点标定数据。当前尚未完成。** 此项是开发阶段待办，不是某个日期的定时通知。

- [x] 确认板型为亚博 K230 视觉识别模块，摄像头为 GC2093；按用户最新说明采用未接显示屏的无屏运行方案。
- [x] 确认靶心为外框几何中心 (148.5, 105.0) mm，外框 297 mm × 210 mm，内框 261 mm × 174 mm。
- [ ] 用 CanMV IDE 读取并记录板上实际固件版本，验证 RGB565 / `cv2` 图像适配，并确定最终检测分辨率。
- [ ] 验证实际固件的无屏采图及媒体资源初始化流程，确认不依赖物理显示屏；图像预览仅用于临时调试。
- [ ] 复核靶框实际贴边及相机/激光的光学中心间距；18 mm 是已提供的安装间距。
- [ ] 在近正视条件下采集至少 500、1000、1500 mm 三档实际落点，覆盖实际视线距离时增加采样范围；明确每个距离的测量起点和方向。
- [ ] 同一距离下移动靶框在画面中的位置，并改变倾斜，验证预测误差有正确方向和量级。
- [ ] 覆盖车辆实际运动中的倾斜和距离，验证 D1≤20 mm；单独测量光斑直径≤5 mm。
- [ ] 检查 0.5°死区带来的精度余量，再决定是否调整云台参数；近正视 1500 mm 时该角度对应约 13.1 mm。

## 7. 实现时不要做的事

- 不要把毫米差直接写入 `yaw_error_deg` / `pitch_error_deg`。
- 不要在 K230 上乘 `VISION_YAW_DIR`、动态增益或 0.5° 死区。死区是 `VISION_DEADZONE_DEG`，增益阈值是 5° 和 2°，都在云台。
- 不要发送像素坐标、`404` 或旧的 `T`/`N` 帧。
- 不要把 `docs/examples/vision_protocol.py` 拷到 K230 当主程序。它没有相机和 UART。
- 不要在 IDE 预览开着的时候用画面上的 FPS 判断算法速度。

## 8. 联调顺序

代码与部署、采图、相机/激光标定步骤见 [vision/README.md](../vision/README.md)。第一版已实现，电脑验证范围见该文件，实际固件和硬件验证待完成。

1. 不接云台，在 K230 上打印两帧标准串：`2.500,-1.000` 对应 `*3C12`，无目标对应 `*A424`。
2. 只发小角度，例如 2°，确认云台上电 5 秒后开始动，且方向最终朝靶心。方向反了只改云台方向系数。
3. 遮住靶纸，确认连续发出 `valid=0`，云台保持自稳，不再追最后一次的有效角度。
4. 补齐上述标定待办后，在近、中、远距离及实际斜视角度检查 D1。若只在单个距离对准，应分别检查标定、距离/姿态估计、光轴关系和控制误差，不能只归因于垂直插值。

## 9. 后续画圆扩展

本阶段先实现静态靶心瞄准，后续需要支持靶平面半径 60 mm 的圆弧轨迹，按 D2≤20 mm 验收。

视觉内部将“当前期望命中点”与“预测激光落点”分开：静态模式的期望点为靶心，画圆模式在同一毫米坐标系生成圆周目标点，例如 `center + 60×(cos(phi), sin(phi))`。选择起点、旋转方向和相位推进方式时需考虑靶平面 y 向下的约定。

两种模式都把“期望点相对预测落点”的偏差转换成角度，仍可复用当前 `$V` 误差帧。圆心已确认为 (148.5, 105.0) mm。现有协议尚未定义画圆开始/停止、周期、相位或底盘转弯时暂停/恢复的指令；这些需要在下一阶段补充，不能把 `$V` 本身当成画圆任务触发命令。完成时间、画圆方向和触发来源尚待确认。

## 10. 位姿误差（`pose reprojection error`）离线分析（2026-10-22）

上板时曾有大量帧因位姿重投影误差超过 `MAX_REPROJECTION_ERROR_PX`（3 px）被判无效，擦镜头后明显改善。用 `vision/captures/` 下 109 张图离线复核：

- 二值化阈值（70、场景均值 × 0.4～0.85，有无 Canny 边缘）对误差几乎没有影响，中位数都约 1.9 px；只有关掉边缘时变差（0.85 × 均值无边缘：2.29 px）。因此「跟踪时锁定阈值」不会减少无效帧，没有实施。
- 误差主要取决于采集批次：`laser_new`（当时镜头发雾）中位数 3.06 px，33 张里 18 张超过 3 px；`targetcheck` 1.64 px、`laser_far` 1.50 px，各只有 2 张超过。
- 残差约为靶框对角线像素长度的 1%，与距离无关；在 300～330 × 225～242 mm 范围内搜索靶尺寸，最好的结果也只把中位数降低 0.1～0.5 px，说明 315 × 233 mm 的配置没有问题。

结论：无效帧多时先擦镜头、检查对焦和光照。运动中有效帧比例可以用蓝牙遥测的标志位统计（`gimbal/tools/telemetry_log.py analyze`）；若镜头干净但车动起来比例仍明显下降，再考虑把 `MAX_REPROJECTION_ERROR_PX` 放宽到 4。
