helu33/25-aiming-cart/vision/CAMERA_CALIBRATION_REPORT.md

# GC2093 相机标定记录（2026-10-17）

本次使用 `captures/chessboard/` 已有的 91 张实拍 BMP，不改动或删除原图。棋盘规格由用户确认：10×7 个方格、9×6 个内角点、格边长 20 mm。图像均为 640×480。实际格边长和平整度依据用户提供的数据，未另行物理测量。

结果文件为 `camera.json`。`camera.calibrated=true`，`laser.calibrated=false`；不能将相机内参标定当作相机与激光之间的标定。

## 计算结果

| 项目 | 结果 |
|---|---:|
| 输入图片数 | 91 |
| 棋盘识别成功、参与拟合 | 85 |
| 未识别、跳过 | 6 |
| 整体 RMS 重投影误差 | 0.391464 px |
| 单图 RMS 中位数（重新估计外参） | 0.200939 px |
| 最差单图 RMS | 1.646939 px |
| fx / fy | 385.980776 / 514.740440 px |
| cx / cy | 318.439871 / 259.944246 px |

畸变系数顺序为 `[k1,k2,p1,p2,k3]`：

```text
[-0.0303490623, -0.0389638370, -0.0005111051, 0.0014376944, 0.1146951914]
```

结果通过现有工具的整体 RMS≤1 px、最差单图 RMS≤2 px 门限。重投影误差描述模型与角点的一致程度，不等同于靶上毫米定位误差。

## 验证与限制

按文件名排序，每五张成功识别照片留一张，使用 68 张重新拟合内参，再对另外 17 张估计外参并检查重投影。验证集单图 RMS 的平均值为 0.360168 px，最大值为 1.581471 px；与全量拟合相比，fx 和 fy 分别变化约 0.0045% 和 0.0313%。两组可能含相似拍摄姿态，这不是独立实物精度验收。

检测角点覆盖 x≈77.5～525.5、y≈46.2～455.8 px，画面最左、最右边缘覆盖不足。姿态模型估计的斜视范围约 0.6°～58.5°。建议后续补充左、右边缘清晰照片，并使完整棋盘留在画面内，增强边缘畸变约束。

误差较大的图片包括 `frame_104640_0.bmp`、`frame_50759_0.bmp`、`frame_73490_0.bmp`、`frame_64993_0.bmp`、`frame_67073_0.bmp`，其最大单角点残差约 5.6～8.3 px。已保留在本次全量拟合中，没有为了降低 RMS 自动删除；建议复拍或复核角点、棋盘平整度和运动模糊。详细数值保存在 `camera_validation.json`。

fx 与 fy 不相等，不应手动改成相等。它们与相机成像、图像缩放及标定样本有关；后续必须维持同一分辨率、裁剪、镜像和镜头设置，并用实际场景验证。

## 接下来怎么使用

1. 保留电脑上的 `camera.json`，作为下一步激光标定的输入。
2. 相机采图完成后，将板端 `CAPTURE_INTERVAL_MS` 改回 0，停止定时写卡。不要仅为了启用控制而手改 `laser.calibrated`。
3. 收集近、中、远距离的实际光斑落点以及同一原图的外框四角。之前约定的 18 mm 安装间距不能替代这一步。
4. 用 `tools/calibrate.py laser camera.json laser_samples.json --output calibration.json` 合并生成完整文件；完成后再将 `calibration.json` 复制到板上 `/sdcard/k230_vision/`。

若仅把本次 `camera.json` 内容作为 `calibration.json` 放到板上，程序仍会提示 `laser_not_calibrated` 并发送无效控制帧，这是预期行为。

计算方法参考 [OpenCV 官方相机标定文档](https://docs.opencv.org/5.0/py_tutorials/py_calib3d/py_calibration/py_calibration.html)。电脑端使用仓库 `tools/calibrate.py`；复核脚本位于仓库 `vision/tools/check_camera_calibration.py`。

# 激光标定记录（2026-10-18）

照片：`captures/laser/` 48 张彩色 BMP（采图版，`deploy.ps1 -LaserCapture`），绿色激光。工具：`tools/extract_laser_samples.py`。

- **靶尺寸**：练习靶黑框外沿实测 315×233 mm，胶带 20 mm（不是 A4 的 297×210/18）。按 A4 计算时位姿残差中位 4.2～4.4 px、多数帧被 3 px 门限拒绝；改用实测尺寸后中位 1.6～1.7 px。`config.py` 已改为实测值；正式比赛 A4 靶需改回。
- **安装变动**：照片分两批，各自直线拟合良好，但激光方向相差约 1.2°。用户确认后拍的 A 批（frame_2xxxxx，17 个有效样本）代表当前安装，先拍的 B 批未使用。
- **结果**：`origin_mm`≈(−0.1, −18.4, 0)，激光在相机上方约 18 mm，方向≈(0.0070, −0.0261, 0.9996)；最大拟合残差 2.70 mm；深度覆盖 569～937 mm。
- **验证**：按正式灰度流程处理，A 批预测落点与实际光斑在靶面上平均差 2.3 mm、最大 3.8 mm（样本内）；B 批平均 20.1 mm、最大 32.9 mm，说明 1.2° 的安装变化即超出 D1≤2 cm。
- **限制**：没有 1.25 m 以上可用样本，远距离为外推；精度仍需上车实打验证。激光或相机被碰、调整后必须重新标定。

## 远距离补拍与重新标定（2026-10-18，第二次）

- 新照片 17 张移至 `captures/laser_far/`，14 张可用，距离 0.70～1.41 m。用第一次（A 批）标定预测，光斑一致偏差 6～14 mm 且随距离增大；两批各自拟合残差约 1.1 mm，合并后升至 7.4 mm，方向相差 0.62°，原点不变（均在相机上方约 18.5 mm）。判断为激光笔在支架内转动，而不是 A 批外推误差。
- 按"最后一次拍摄代表当前安装"，改用新批次生成 `calibration.json`：最大残差 3.37 mm，深度 691～1409 mm；留一法预测落点平均 2.3 mm、最大 5.3 mm。旧结果保留为 `calibration_A_backup.json` / `laser_samples_A.json`。
- 三次拍摄间激光方向分别变化 1.2° 和 0.6°（1 m 处约 21 mm 和 11 mm），已接近或超过 D1≤2 cm。精度瓶颈在激光固定，必须先固定牢（检查按开关是否带动笔身），并在每次调整后重新标定。

## 激光重新固定后的最终标定（2026-10-18，第三次）

- 用户重新固定激光笔（位置相对前次有变化），照片 39 张在 `captures/laser_new/`，同一次开机连续拍摄，中间转动过云台（以 173 s 与 187 s 之间的空档分段）。
- 16 张可用；排除 2 张光斑被靶心深色圆环切断（frame_153211）或紧贴胶带（frame_198541）造成中心偏移的样本，余 14 张，深度 550～1459 mm。
- **稳定性验证**：第一段（11 张）拟合的射线预测云台转动后的第二段，偏差 1.2～2.9 mm（前两次换批时为 20 mm、11 mm），固定已有效。
- **结果**：`origin_mm`≈(1.6, −22.4, 0)，最大拟合残差 3.21 mm；留一法预测落点平均 3.3 mm、最大 7.3 mm（最大值为去掉唯一近距离样本时的外推）。前一版标定预测本批平均偏差 5.8 mm，与"激光位置已变"一致。
- 旧结果保留为 `calibration_far_backup.json` / `laser_samples_far.json`。
- 本批图像整体发灰，位姿残差中位约 3 px（前一批约 1.3 px），约一半帧超出 3 px 门限；运行时会有部分帧输出无效，建议擦拭镜头、避免顶灯直射镜头。
