helu33/25-aiming-cart/chassis/Core/Inc/main.h

#define BUZZER_Pin GPIO_PIN_1
#define BUZZER_GPIO_Port GPIOB
#define RGB_R_Pin GPIO_PIN_4
#define RGB_R_GPIO_Port GPIOB
#define RGB_G_Pin GPIO_PIN_5
#define RGB_G_GPIO_Port GPIOC
#define RGB_B_Pin GPIO_PIN_8
#define RGB_B_GPIO_Port GPIOC
