helu33/25-aiming-cart/gimbal/Bsp/w25q64.c

//有关spi的模拟协议。
#include "w25q64.h"

extern OSPI_HandleTypeDef hospi2;

/*************************************************************************************************
*	函 数 名: OSPI_W25Qxx_Init
*	入口参数: 无
*	返 回 值: OSPI_W25Qxx_OK - 初始化成功，W25Qxx_ERROR_INIT - 初始化错误
*	函数功能: 初始化 OSPI 配置，读取W25Q64ID
*	说    明: 无	
*************************************************************************************************/

int8_t OSPI_W25Qxx_Init(void)
{
    uint32_t    Device_ID;  // 器件ID
    
    
    
    Device_ID = OSPI_W25Qxx_ReadID();       // 读取器件ID
    
    if( Device_ID == W25Qxx_FLASH_ID )      // 进行匹配
    {
//        printf ("W25Q64 OK,flash ID:%X\r\n",Device_ID);		// 初始化成功
        return OSPI_W25Qxx_OK;              // 返回成功标志		
    }
    else
    {
//        printf ("W25Q64 ERROR!!!!!  ID:%X\r\n",Device_ID);	// 初始化失败	
        return W25Qxx_ERROR_INIT;           // 返回错误标志
    }   
}

/*************************************************************************************************
*	函 数 名: OSPI_W25Qxx_AutoPollingMemReady
*	入口参数: 无
*	返 回 值: OSPI_W25Qxx_OK - 通信正常结束，W25Qxx_ERROR_AUTOPOLLING - 轮询等待无响应
*	函数功能: 使用自动轮询标志查询，等待通信结束
*	说    明: 每一次通信都应该调用此函数，等待通信结束，避免错误的操作	
******************************************************************************************FANKE*****/

int8_t OSPI_W25Qxx_AutoPollingMemReady(void)
{
    OSPI_RegularCmdTypeDef  sCommand;		// OSPI传输配置
    OSPI_AutoPollingTypeDef sConfig;			// 轮询比较相关配置参数
    
    sCommand.OperationType      = HAL_OSPI_OPTYPE_COMMON_CFG;         // 通用配置
    sCommand.FlashId            = HAL_OSPI_FLASH_ID_1;                // flash ID
    sCommand.InstructionMode    = HAL_OSPI_INSTRUCTION_1_LINE;        // 1线指令模式
    sCommand.InstructionSize    = HAL_OSPI_INSTRUCTION_8_BITS;        // 指令长度8位
    sCommand.InstructionDtrMode = HAL_OSPI_INSTRUCTION_DTR_DISABLE;   // 禁止指令DTR模式
    sCommand.Address            = 0x0;                                // 地址0
    sCommand.AddressMode        = HAL_OSPI_ADDRESS_NONE;              // 无地址模式
    sCommand.AddressSize        = HAL_OSPI_ADDRESS_24_BITS;           // 地址长度24位
    sCommand.AddressDtrMode     = HAL_OSPI_ADDRESS_DTR_DISABLE;       // 禁止地址DTR模式
    sCommand.AlternateBytesMode = HAL_OSPI_ALTERNATE_BYTES_NONE;      //	无交替字节
    sCommand.DataMode           = HAL_OSPI_DATA_1_LINE;               // 1线数据模式
    sCommand.DataDtrMode        = HAL_OSPI_DATA_DTR_DISABLE;          // 禁止数据DTR模式
    sCommand.NbData             = 1;                                  // 通信数据长度
    sCommand.DummyCycles        = 0;                                  // 空周期个数
    sCommand.DQSMode            = HAL_OSPI_DQS_DISABLE;               // 不使用DQS
    sCommand.SIOOMode           = HAL_OSPI_SIOO_INST_EVERY_CMD;       // 每次传输数据都发送指令
    
    sCommand.Instruction        = W25Qxx_CMD_ReadStatus_REG1;         // 读状态信息寄存器
    
    if (HAL_OSPI_Command(&hospi2, &sCommand, HAL_OSPI_TIMEOUT_DEFAULT_VALUE) != HAL_OK)
    {
        return W25Qxx_ERROR_AUTOPOLLING; // 轮询等待无响应
    }

// 不停的查询 W25Qxx_CMD_ReadStatus_REG1 寄存器，将读取到的状态字节中的 W25Qxx_Status_REG1_BUSY 不停的与0作比较
// 读状态寄存器1的第0位（只读），Busy标志位，当正在擦除/写入数据/写命令时会被置1，空闲或通信结束为0
// FANKE	
    sConfig.Match         = 0;                                      //	匹配值	
    sConfig.MatchMode     = HAL_OSPI_MATCH_MODE_AND;                //	与运算
    sConfig.Interval      = 0x10;                                   //	轮询间隔
    sConfig.AutomaticStop = HAL_OSPI_AUTOMATIC_STOP_ENABLE;         // 自动停止模式
    sConfig.Mask          = W25Qxx_Status_REG1_BUSY;                // 对在轮询模式下接收的状态字节进行屏蔽，只比较需要用到的位
    
    // 发送轮询等待命令
    if (HAL_OSPI_AutoPolling(&hospi2, &sConfig,HAL_OSPI_TIMEOUT_DEFAULT_VALUE) != HAL_OK)
    {
        return W25Qxx_ERROR_AUTOPOLLING; // 轮询等待无响应
    }
    return OSPI_W25Qxx_OK; // 通信正常结束	
}

/*************************************************************************************************
*	函 数 名: OSPI_W25Qxx_ReadID
*	入口参数: 无
*	返 回 值: W25Qxx_ID - 读取到的器件ID，W25Qxx_ERROR_INIT - 通信、初始化错误
*	函数功能: 初始化 OSPI 配置，读取器件ID
*	说    明: 无	
**************************************************************************************************/

uint32_t OSPI_W25Qxx_ReadID(void)	
{
    OSPI_RegularCmdTypeDef  sCommand;		// OSPI传输配置
    
    uint8_t	OSPI_ReceiveBuff[3];		      // 存储OSPI读到的数据
    uint32_t	W25Qxx_ID;					      // 器件的ID
    
    sCommand.OperationType      = HAL_OSPI_OPTYPE_COMMON_CFG;         // 通用配置
    sCommand.FlashId            = HAL_OSPI_FLASH_ID_1;                // flash ID
    sCommand.InstructionMode    = HAL_OSPI_INSTRUCTION_1_LINE;        // 1线指令模式
    sCommand.InstructionSize    = HAL_OSPI_INSTRUCTION_8_BITS;        // 指令长度8位
    sCommand.InstructionDtrMode = HAL_OSPI_INSTRUCTION_DTR_DISABLE;   // 禁止指令DTR模式
    sCommand.AddressMode        = HAL_OSPI_ADDRESS_NONE;              // 无地址模式
    sCommand.AddressSize        = HAL_OSPI_ADDRESS_24_BITS;           // 地址长度24位   
    sCommand.AlternateBytesMode = HAL_OSPI_ALTERNATE_BYTES_NONE;      //	无交替字节
    sCommand.DataMode           = HAL_OSPI_DATA_1_LINE;               // 1线数据模式
    sCommand.DataDtrMode        = HAL_OSPI_DATA_DTR_DISABLE;          // 禁止数据DTR模式
    sCommand.NbData             = 3;                                  // 传输数据的长度
    sCommand.DummyCycles        = 0;                                  // 空周期个数
    sCommand.DQSMode            = HAL_OSPI_DQS_DISABLE;               // 不使用DQS
    sCommand.SIOOMode           = HAL_OSPI_SIOO_INST_EVERY_CMD;       // 每次传输数据都发送指令   
    
    sCommand.Instruction        = W25Qxx_CMD_JedecID;                 // 执行读器件ID命令
    
    
    HAL_OSPI_Command(&hospi2, &sCommand, HAL_OSPI_TIMEOUT_DEFAULT_VALUE);	// 发送指令
    
    HAL_OSPI_Receive (&hospi2, OSPI_ReceiveBuff, HAL_OSPI_TIMEOUT_DEFAULT_VALUE);	// 接收数据
    
    W25Qxx_ID = (OSPI_ReceiveBuff[0] << 16) | (OSPI_ReceiveBuff[1] << 8 ) | OSPI_ReceiveBuff[2];	// 将得到的数据组合成ID
    
    return W25Qxx_ID; // 返回ID
}


/*************************************************************************************************
*	函 数 名: OSPI_W25Qxx_MemoryMappedMode
*	入口参数: 无
*	返 回 值: OSPI_W25Qxx_OK - 写使能成功，W25Qxx_ERROR_WriteEnable - 写使能失败
*	函数功能: 将OSPI设置为内存映射模式
*	说    明: 无
**************************************************************************************************/

int8_t OSPI_W25Qxx_MemoryMappedMode(void)
{
   OSPI_RegularCmdTypeDef     sCommand;         // QSPI传输配置
   OSPI_MemoryMappedTypeDef   sMemMappedCfg;    // 内存映射访问参数

   sCommand.OperationType           = HAL_OSPI_OPTYPE_COMMON_CFG;             // 通用配置
   sCommand.FlashId                 = HAL_OSPI_FLASH_ID_1;                    // flash ID

   sCommand.Instruction             = W25Qxx_CMD_FastReadQuad_IO;             // 1-4-4模式下(1线指令4线地址4线数据)，快速读取指令
   sCommand.InstructionMode         = HAL_OSPI_INSTRUCTION_1_LINE;            // 1线指令模式
   sCommand.InstructionSize         = HAL_OSPI_INSTRUCTION_8_BITS;            // 指令长度8位
   sCommand.InstructionDtrMode      = HAL_OSPI_INSTRUCTION_DTR_DISABLE;       // 禁止指令DTR模式

   sCommand.AddressMode             = HAL_OSPI_ADDRESS_4_LINES;               // 4线地址模式
   sCommand.AddressSize             = HAL_OSPI_ADDRESS_24_BITS;               // 地址长度24位
   sCommand.AddressDtrMode          = HAL_OSPI_ADDRESS_DTR_DISABLE;           // 禁止地址DTR模式

   sCommand.AlternateBytesMode      = HAL_OSPI_ALTERNATE_BYTES_NONE;          // 无交替字节    
   sCommand.AlternateBytesDtrMode   = HAL_OSPI_ALTERNATE_BYTES_DTR_DISABLE;   // 禁止替字节DTR模式 

   sCommand.DataMode                = HAL_OSPI_DATA_4_LINES;                  // 4线数据模式
   sCommand.DataDtrMode             = HAL_OSPI_DATA_DTR_DISABLE;              // 禁止数据DTR模式 

   sCommand.DummyCycles             = 6;                                      // 空周期个数
   sCommand.DQSMode                 = HAL_OSPI_DQS_DISABLE;                   // 不使用DQS 
   sCommand.SIOOMode                = HAL_OSPI_SIOO_INST_EVERY_CMD;           // 每次传输数据都发送指令   

    // 写配置
    if (HAL_OSPI_Command(&hospi2, &sCommand, HAL_OSPI_TIMEOUT_DEFAULT_VALUE) != HAL_OK)
    {
        return W25Qxx_ERROR_TRANSMIT;		// 传输数据错误
    }   
    
    sMemMappedCfg.TimeOutActivation  = HAL_OSPI_TIMEOUT_COUNTER_DISABLE;          // 禁用超时计数器, nCS 保持激活状态
    sMemMappedCfg.TimeOutPeriod      = 0;                                         // 超时判断周期
    // 开启内存映射模式
    if (HAL_OSPI_MemoryMapped(&hospi2,  &sMemMappedCfg) != HAL_OK)	// 进行配置
    {
        return W25Qxx_ERROR_MemoryMapped; 	// 设置内存映射模式错误
    }
    return OSPI_W25Qxx_OK; // 配置成功
}

/*************************************************************************************************
*   函 数 名: OSPI_W25Qxx_WriteEnable
*   入口参数: 无
*   返 回 值: OSPI_W25Qxx_OK - 写使能成功，W25Qxx_ERROR_WriteEnable - 写使能失败
*   函数功能: 发送写使能命令
*   说    明: 无	
**************************************************************************************************/

int8_t OSPI_W25Qxx_WriteEnable(void)
{
   OSPI_RegularCmdTypeDef  sCommand;// OSPI传输配置
   OSPI_AutoPollingTypeDef sConfig;// 轮询比较相关配置参数

   sCommand.OperationType           = HAL_OSPI_OPTYPE_COMMON_CFG;             // 通用配置
   sCommand.FlashId                 = HAL_OSPI_FLASH_ID_1;                    // flash ID                       
   sCommand.InstructionMode         = HAL_OSPI_INSTRUCTION_1_LINE;            // 1线指令模式
   sCommand.InstructionSize         = HAL_OSPI_INSTRUCTION_8_BITS;            // 指令长度8位
   sCommand.InstructionDtrMode      = HAL_OSPI_INSTRUCTION_DTR_DISABLE;       // 禁止指令DTR模式
   sCommand.Address                 = 0;                                      // 地址0
   sCommand.AddressMode             = HAL_OSPI_ADDRESS_NONE;                  // 无地址模式   
   sCommand.AddressSize             = HAL_OSPI_ADDRESS_24_BITS;               // 地址长度24位
   sCommand.AddressDtrMode          = HAL_OSPI_ADDRESS_DTR_DISABLE;           // 禁止地址DTR模式
   sCommand.AlternateBytesDtrMode   = HAL_OSPI_ALTERNATE_BYTES_DTR_DISABLE;   //	禁止替字节DTR模式
   sCommand.AlternateBytesMode      = HAL_OSPI_ALTERNATE_BYTES_NONE;          //	无交替字节
   sCommand.DataMode                = HAL_OSPI_DATA_NONE;                     // 无数据模式
   sCommand.DataDtrMode             = HAL_OSPI_DATA_DTR_DISABLE;              // 禁止数据DTR模式
   sCommand.DummyCycles             = 0;                                      // 空周期个数
   sCommand.DQSMode                 = HAL_OSPI_DQS_DISABLE;                   // 不使用DQS
   sCommand.SIOOMode                = HAL_OSPI_SIOO_INST_EVERY_CMD;           // 每次传输数据都发送指令

   sCommand.Instruction             = W25Qxx_CMD_WriteEnable;                 // 写使能命令

   // 发送写使能命令
   if (HAL_OSPI_Command(&hospi2, &sCommand, HAL_OSPI_TIMEOUT_DEFAULT_VALUE) != HAL_OK)
   {
      return W25Qxx_ERROR_WriteEnable;	
   }
   // 发送查询状态寄存器命令 
   sCommand.OperationType      = HAL_OSPI_OPTYPE_COMMON_CFG;         // 通用配置
   sCommand.FlashId            = HAL_OSPI_FLASH_ID_1;                // flash ID 
   sCommand.InstructionMode    = HAL_OSPI_INSTRUCTION_1_LINE;        // 1线指令模式
   sCommand.InstructionSize    = HAL_OSPI_INSTRUCTION_8_BITS;        // 指令长度8位
   sCommand.InstructionDtrMode = HAL_OSPI_INSTRUCTION_DTR_DISABLE;   // 禁止指令DTR模式
   sCommand.AddressMode        = HAL_OSPI_ADDRESS_NONE;              // 无地址模式  
   sCommand.AlternateBytesMode = HAL_OSPI_ALTERNATE_BYTES_NONE;      //	无交替字节   
   sCommand.DummyCycles        = 0;                                  // 空周期个数
   sCommand.DQSMode            = HAL_OSPI_DQS_DISABLE;               // 不使用DQS   
   sCommand.SIOOMode           = HAL_OSPI_SIOO_INST_EVERY_CMD;       // 每次传输数据都发送指令
   sCommand.DataMode           = HAL_OSPI_DATA_1_LINE;               // 1线数据模式
   sCommand.NbData             = 1;                                  // 通信数据长度

   sCommand.Instruction        = W25Qxx_CMD_ReadStatus_REG1;         // 查询状态寄存器命令

   if (HAL_OSPI_Command(&hospi2, &sCommand, HAL_OSPI_TIMEOUT_DEFAULT_VALUE) != HAL_OK)
   {
      return W25Qxx_ERROR_WriteEnable;	
   }

// 不停的查询 W25Qxx_CMD_ReadStatus_REG1 寄存器，将读取到的状态字节中的 W25Qxx_Status_REG1_WEL 不停的与 0x02 作比较
// 读状态寄存器1的第1位（只读），WEL写使能标志位，该标志位为1时，代表可以进行写操作
// FANKE	7B0	
    sConfig.Match         = 0x02;										//	匹配值	
    sConfig.MatchMode     = HAL_OSPI_MATCH_MODE_AND;			//	与运算
    sConfig.Interval      = 0x10;										//	轮询间隔
    sConfig.AutomaticStop = HAL_OSPI_AUTOMATIC_STOP_ENABLE;	// 自动停止模式
    sConfig.Mask          = W25Qxx_Status_REG1_WEL; 			// 对在轮询模式下接收的状态字节进行屏蔽，只比较需要用到的位
    
    if (HAL_OSPI_AutoPolling(&hospi2, &sConfig,HAL_OSPI_TIMEOUT_DEFAULT_VALUE) != HAL_OK)
    {
        return W25Qxx_ERROR_AUTOPOLLING; // 轮询等待无响应
    }
    return OSPI_W25Qxx_OK;  // 通信正常结束
}

/*************************************************************************************************
*
*	函 数 名: OSPI_W25Qxx_SectorErase
*
*	入口参数: SectorAddress - 要擦除的地址
*
*	返 回 值: OSPI_W25Qxx_OK - 擦除成功
*			    W25Qxx_ERROR_Erase - 擦除失败
*				 W25Qxx_ERROR_AUTOPOLLING - 轮询等待无响应
*
*	函数功能: 进行扇区擦除操作，每次擦除4K字节
*
*	说    明: 1.按照 W25Q64JV 数据手册给出的擦除参考时间，典型值为 45ms，最大值为400ms
*				 2.实际的擦除速度可能大于45ms，也可能小于45ms
*				 3.flash使用的时间越长，擦除所需时间也会越长
*
**************************************************************************************************/

int8_t OSPI_W25Qxx_SectorErase(uint32_t SectorAddress)	
{
    OSPI_RegularCmdTypeDef  sCommand;		// OSPI传输配置
    
    sCommand.OperationType      = HAL_OSPI_OPTYPE_COMMON_CFG;         // 通用配置
    sCommand.FlashId            = HAL_OSPI_FLASH_ID_1;                // flash ID
    sCommand.InstructionMode    = HAL_OSPI_INSTRUCTION_1_LINE;        // 1线指令模式
    sCommand.InstructionSize    = HAL_OSPI_INSTRUCTION_8_BITS;        // 指令长度8位
    sCommand.InstructionDtrMode = HAL_OSPI_INSTRUCTION_DTR_DISABLE;   // 禁止指令DTR模式
    sCommand.Address            = SectorAddress;                      // 地址
    sCommand.AddressMode        = HAL_OSPI_ADDRESS_1_LINE;            // 1线地址模式
    sCommand.AddressSize        = HAL_OSPI_ADDRESS_24_BITS;           // 地址长度24位
    sCommand.AddressDtrMode     = HAL_OSPI_ADDRESS_DTR_DISABLE;       // 禁止地址DTR模式
    sCommand.AlternateBytesMode = HAL_OSPI_ALTERNATE_BYTES_NONE;      //	无交替字节
    sCommand.DataMode           = HAL_OSPI_DATA_NONE;                 // 无数据模式
    sCommand.DataDtrMode        = HAL_OSPI_DATA_DTR_DISABLE;          // 禁止数据DTR模式
    sCommand.DummyCycles        = 0;                                  // 空周期个数
    sCommand.DQSMode            = HAL_OSPI_DQS_DISABLE;               // 不使用DQS
    sCommand.SIOOMode           = HAL_OSPI_SIOO_INST_EVERY_CMD;       // 每次传输数据都发送指令
    
    sCommand.Instruction        = W25Qxx_CMD_SectorErase;             // 扇区擦除指令，每次擦除4K字节
    
    // 发送写使能
    if (OSPI_W25Qxx_WriteEnable() != OSPI_W25Qxx_OK)
    {
        return W25Qxx_ERROR_WriteEnable;		// 写使能失败
    }
    // 发送擦除指令
    if (HAL_OSPI_Command(&hospi2, &sCommand, HAL_OSPI_TIMEOUT_DEFAULT_VALUE) != HAL_OK)
    {
        return W25Qxx_ERROR_AUTOPOLLING; // 轮询等待无响应
    }   
    // 使用自动轮询标志位，等待擦除的结束 
    if (OSPI_W25Qxx_AutoPollingMemReady() != OSPI_W25Qxx_OK)
    {
        return W25Qxx_ERROR_AUTOPOLLING;		// 轮询等待无响应
    }
    return OSPI_W25Qxx_OK; // 擦除成功
}

/*************************************************************************************************
*
*	函 数 名: OSPI_W25Qxx_BlockErase_32K
*
*	入口参数: SectorAddress - 要擦除的地址
*
*	返 回 值: OSPI_W25Qxx_OK - 擦除成功
*			    W25Qxx_ERROR_Erase - 擦除失败
*				 W25Qxx_ERROR_AUTOPOLLING - 轮询等待无响应
*
*	函数功能: 进行块擦除操作，每次擦除32K字节
*
*	说    明: 1.按照 W25Q64JV 数据手册给出的擦除参考时间，典型值为 120ms，最大值为1600ms
*				 2.实际的擦除速度可能大于120ms，也可能小于120ms
*				 3.flash使用的时间越长，擦除所需时间也会越长
*
*************************************************************************************************/

int8_t OSPI_W25Qxx_BlockErase_32K (uint32_t SectorAddress)	
{
    OSPI_RegularCmdTypeDef  sCommand;		// OSPI传输配置
    
    sCommand.OperationType      = HAL_OSPI_OPTYPE_COMMON_CFG;         // 通用配置
    sCommand.FlashId            = HAL_OSPI_FLASH_ID_1;                // flash ID
    sCommand.InstructionMode    = HAL_OSPI_INSTRUCTION_1_LINE;        // 1线指令模式
    sCommand.InstructionSize    = HAL_OSPI_INSTRUCTION_8_BITS;        // 指令长度8位
    sCommand.InstructionDtrMode = HAL_OSPI_INSTRUCTION_DTR_DISABLE;   // 禁止指令DTR模式
    sCommand.Address            = SectorAddress;                      // 地址
    sCommand.AddressMode        = HAL_OSPI_ADDRESS_1_LINE;            // 1线地址模式
    sCommand.AddressSize        = HAL_OSPI_ADDRESS_24_BITS;           // 地址长度24位
    sCommand.AddressDtrMode     = HAL_OSPI_ADDRESS_DTR_DISABLE;       // 禁止地址DTR模式
    sCommand.AlternateBytesMode = HAL_OSPI_ALTERNATE_BYTES_NONE;      //	无交替字节
    sCommand.DataMode           = HAL_OSPI_DATA_NONE;                 // 无数据模式
    sCommand.DataDtrMode        = HAL_OSPI_DATA_DTR_DISABLE;          // 禁止数据DTR模式
    sCommand.DummyCycles        = 0;                                  // 空周期个数
    sCommand.DQSMode            = HAL_OSPI_DQS_DISABLE;               // 不使用DQS
    sCommand.SIOOMode           = HAL_OSPI_SIOO_INST_EVERY_CMD;       // 每次传输数据都发送指令
    
    sCommand.Instruction        = W25Qxx_CMD_BlockErase_32K;          // 块擦除指令，每次擦除32K字节
    
    // 发送写使能
    if (OSPI_W25Qxx_WriteEnable() != OSPI_W25Qxx_OK)
    {
        return W25Qxx_ERROR_WriteEnable;		// 写使能失败
    }
    // 发送擦除指令
    if (HAL_OSPI_Command(&hospi2, &sCommand, HAL_OSPI_TIMEOUT_DEFAULT_VALUE) != HAL_OK)
    {
        return W25Qxx_ERROR_AUTOPOLLING; // 轮询等待无响应
    }   
    // 使用自动轮询标志位，等待擦除的结束 
    if (OSPI_W25Qxx_AutoPollingMemReady() != OSPI_W25Qxx_OK)
    {
        return W25Qxx_ERROR_AUTOPOLLING;		// 轮询等待无响应
    }
    return OSPI_W25Qxx_OK; // 擦除成功	
}

/*************************************************************************************************
*
*	函 数 名: OSPI_W25Qxx_BlockErase_64K
*
*	入口参数: SectorAddress - 要擦除的地址
*
*	返 回 值: OSPI_W25Qxx_OK - 擦除成功
*			    W25Qxx_ERROR_Erase - 擦除失败
*				 W25Qxx_ERROR_AUTOPOLLING - 轮询等待无响应
*
*	函数功能: 进行块擦除操作，每次擦除64K字节
*
*	说    明: 1.按照 W25Q64JV 数据手册给出的擦除参考时间，典型值为 150ms，最大值为2000ms
*				 2.实际的擦除速度可能大于150ms，也可能小于150ms
*				 3.flash使用的时间越长，擦除所需时间也会越长
*				 4.实际使用建议使用64K擦除，擦除的时间最快
*
**************************************************************************************************/
int8_t OSPI_W25Qxx_BlockErase_64K (uint32_t SectorAddress)	
{
    OSPI_RegularCmdTypeDef  sCommand;		// OSPI传输配置
    
    sCommand.OperationType      = HAL_OSPI_OPTYPE_COMMON_CFG;         // 通用配置
    sCommand.FlashId            = HAL_OSPI_FLASH_ID_1;                // flash ID
    sCommand.InstructionMode    = HAL_OSPI_INSTRUCTION_1_LINE;        // 1线指令模式
    sCommand.InstructionSize    = HAL_OSPI_INSTRUCTION_8_BITS;        // 指令长度8位
    sCommand.InstructionDtrMode = HAL_OSPI_INSTRUCTION_DTR_DISABLE;   // 禁止指令DTR模式
    sCommand.Address            = SectorAddress;                      // 地址
    sCommand.AddressMode        = HAL_OSPI_ADDRESS_1_LINE;            // 1线地址模式
    sCommand.AddressSize        = HAL_OSPI_ADDRESS_24_BITS;           // 地址长度24位
    sCommand.AddressDtrMode     = HAL_OSPI_ADDRESS_DTR_DISABLE;       // 禁止地址DTR模式
    sCommand.AlternateBytesMode = HAL_OSPI_ALTERNATE_BYTES_NONE;      //	无交替字节
    sCommand.DataMode           = HAL_OSPI_DATA_NONE;                 // 无数据模式
    sCommand.DataDtrMode        = HAL_OSPI_DATA_DTR_DISABLE;          // 禁止数据DTR模式
    sCommand.DummyCycles        = 0;                                  // 空周期个数
    sCommand.DQSMode            = HAL_OSPI_DQS_DISABLE;               // 不使用DQS
    sCommand.SIOOMode           = HAL_OSPI_SIOO_INST_EVERY_CMD;       // 每次传输数据都发送指令
    
    sCommand.Instruction        = W25Qxx_CMD_BlockErase_64K;          // 扇区擦除指令，每次擦除64K字节
    
    // 发送写使能
    if (OSPI_W25Qxx_WriteEnable() != OSPI_W25Qxx_OK)
    {
        return W25Qxx_ERROR_WriteEnable;		// 写使能失败
    }
    // 发送擦除指令
    if (HAL_OSPI_Command(&hospi2, &sCommand, HAL_OSPI_TIMEOUT_DEFAULT_VALUE) != HAL_OK)
    {
        return W25Qxx_ERROR_AUTOPOLLING; // 轮询等待无响应
    }   
    // 使用自动轮询标志位，等待擦除的结束 
    if (OSPI_W25Qxx_AutoPollingMemReady() != OSPI_W25Qxx_OK)
    {
        return W25Qxx_ERROR_AUTOPOLLING;		// 轮询等待无响应
    }
    return OSPI_W25Qxx_OK; // 擦除成功			
}

/*************************************************************************************************
*
*	函 数 名: OSPI_W25Qxx_ChipErase
*
*	入口参数: 无
*
*	返 回 值: OSPI_W25Qxx_OK - 擦除成功
*			    W25Qxx_ERROR_Erase - 擦除失败
*				 W25Qxx_ERROR_AUTOPOLLING - 轮询等待无响应
*
*	函数功能: 进行整片擦除操作
*
*	说    明: 1.按照 W25Q64JV 数据手册给出的擦除参考时间，典型值为 20s，最大值为100s
*				 2.实际的擦除速度可能大于20s，也可能小于20s
*				 3.flash使用的时间越长，擦除所需时间也会越长
*
*************************************************************************************************/
int8_t OSPI_W25Qxx_ChipErase (void)	
{
    OSPI_RegularCmdTypeDef  sCommand;		// OSPI传输配置
    OSPI_AutoPollingTypeDef sConfig;       // 轮询比较相关配置参数
    
    sCommand.OperationType      = HAL_OSPI_OPTYPE_COMMON_CFG;         // 通用配置
    sCommand.FlashId            = HAL_OSPI_FLASH_ID_1;                // flash ID
    sCommand.InstructionMode    = HAL_OSPI_INSTRUCTION_1_LINE;        // 1线指令模式
    sCommand.InstructionSize    = HAL_OSPI_INSTRUCTION_8_BITS;        // 指令长度8位
    sCommand.InstructionDtrMode = HAL_OSPI_INSTRUCTION_DTR_DISABLE;   // 禁止指令DTR模式
    sCommand.AddressMode        = HAL_OSPI_ADDRESS_NONE;              // 无地址模式
    sCommand.AddressDtrMode     = HAL_OSPI_ADDRESS_DTR_DISABLE;       // 禁止地址DTR模式   
    sCommand.AlternateBytesMode = HAL_OSPI_ALTERNATE_BYTES_NONE;      //	无交替字节
    sCommand.DataMode           = HAL_OSPI_DATA_NONE;                 // 无数据模式
    sCommand.DataDtrMode        = HAL_OSPI_DATA_DTR_DISABLE;          // 禁止数据DTR模式
    sCommand.DummyCycles        = 0;                                  // 空周期个数
    sCommand.DQSMode            = HAL_OSPI_DQS_DISABLE;               // 不使用DQS
    sCommand.SIOOMode           = HAL_OSPI_SIOO_INST_EVERY_CMD;       // 每次传输数据都发送指令
    
    sCommand.Instruction        = W25Qxx_CMD_ChipErase;               // 全片擦除指令
    
    // 发送写使能
    if (OSPI_W25Qxx_WriteEnable() != OSPI_W25Qxx_OK)
    {
        return W25Qxx_ERROR_WriteEnable;		// 写使能失败
    }
    // 发送擦除指令
    if (HAL_OSPI_Command(&hospi2, &sCommand, HAL_OSPI_TIMEOUT_DEFAULT_VALUE) != HAL_OK)
    {
        return W25Qxx_ERROR_AUTOPOLLING; // 轮询等待无响应
    }   
    
    // 发送查询状态寄存器命令
    sCommand.DataMode       = HAL_OSPI_DATA_1_LINE;          // 一线数据模式
    sCommand.NbData         = 1;                             // 数据长度1
    sCommand.Instruction    = W25Qxx_CMD_ReadStatus_REG1;    // 状态寄存器命令
    
    if (HAL_OSPI_Command(&hospi2, &sCommand, HAL_OSPI_TIMEOUT_DEFAULT_VALUE) != HAL_OK)
    {
    return W25Qxx_ERROR_AUTOPOLLING;	
    }

// 不停的查询 W25Qxx_CMD_ReadStatus_REG1 寄存器，将读取到的状态字节中的 W25Qxx_Status_REG1_BUSY 不停的与0作比较
// 读状态寄存器1的第0位（只读），Busy标志位，当正在擦除/写入数据/写命令时会被置1，空闲或通信结束为0
        
    sConfig.Match         = 0;											//	匹配值	
    sConfig.MatchMode     = HAL_OSPI_MATCH_MODE_AND;			//	与运算
    sConfig.Interval      = 0x10;										//	轮询间隔
    sConfig.AutomaticStop = HAL_OSPI_AUTOMATIC_STOP_ENABLE;	// 自动停止模式
    sConfig.Mask          = W25Qxx_Status_REG1_BUSY; 			// 对在轮询模式下接收的状态字节进行屏蔽，只比较需要用到的位
    
    // W25Q64整片擦除的典型参考时间为20s，最大时间为100s，这里的超时等待值 W25Qxx_ChipErase_TIMEOUT_MAX 为 100S
    if (HAL_OSPI_AutoPolling(&hospi2, &sConfig,W25Qxx_ChipErase_TIMEOUT_MAX) != HAL_OK)
    {
        return W25Qxx_ERROR_AUTOPOLLING; // 轮询等待无响应
    }
    return OSPI_W25Qxx_OK; // 擦除成功				
}

/**********************************************************************************************************
*
*	函 数 名: OSPI_W25Qxx_WritePage
*
*	入口参数: pBuffer 		 - 要写入的数据
*				 WriteAddr 		 - 要写入 W25Qxx 的地址
*				 NumByteToWrite - 数据长度，最大只能256字节
*
*	返 回 值: OSPI_W25Qxx_OK 		     - 写数据成功
*			    W25Qxx_ERROR_WriteEnable - 写使能失败
*				 W25Qxx_ERROR_TRANSMIT	  - 传输失败
*				 W25Qxx_ERROR_AUTOPOLLING - 轮询等待无响应
*
*	函数功能: 按页写入，最大只能256字节，在数据写入之前，请务必完成擦除操作
*
*	说    明: 1.Flash的写入时间和擦除时间一样，是限定的，并不是说OSPI驱动时钟133M就可以以这个速度进行写入
*				 2.按照 W25Q64JV 数据手册给出的 页(256字节) 写入参考时间，典型值为 0.4ms，最大值为3ms
*				 3.实际的写入速度可能大于0.4ms，也可能小于0.4ms
*				 4.Flash使用的时间越长，写入所需时间也会越长
*				 5.在数据写入之前，请务必完成擦除操作
*
***********************************************************************************************************/
int8_t OSPI_W25Qxx_WritePage(uint8_t* pBuffer, uint32_t WriteAddr, uint16_t NumByteToWrite)
{
    OSPI_RegularCmdTypeDef  sCommand;// OSPI传输配置
    
    sCommand.OperationType           = HAL_OSPI_OPTYPE_COMMON_CFG;             // 通用配置
    sCommand.FlashId                 = HAL_OSPI_FLASH_ID_1;                    // flash ID
    
    sCommand.Instruction             = W25Qxx_CMD_QuadInputPageProgram;        // 1-1-4模式下(1线指令1线地址4线数据)，页编程指令
    sCommand.InstructionMode         = HAL_OSPI_INSTRUCTION_1_LINE;            // 1线指令模式
    sCommand.InstructionSize         = HAL_OSPI_INSTRUCTION_8_BITS;            // 指令长度8位
    sCommand.InstructionDtrMode      = HAL_OSPI_INSTRUCTION_DTR_DISABLE;       // 禁止指令DTR模式
    
    sCommand.Address                 = WriteAddr;                              // 地址
    sCommand.AddressMode             = HAL_OSPI_ADDRESS_1_LINE;                // 1线地址模式
    sCommand.AddressSize             = HAL_OSPI_ADDRESS_24_BITS;               // 地址长度24位
    sCommand.AddressDtrMode          = HAL_OSPI_ADDRESS_DTR_DISABLE;           // 禁止地址DTR模式
    
    sCommand.AlternateBytesMode      = HAL_OSPI_ALTERNATE_BYTES_NONE;          // 无交替字节         
    sCommand.AlternateBytesDtrMode   = HAL_OSPI_ALTERNATE_BYTES_DTR_DISABLE;   // 禁止替字节DTR模式
    
    sCommand.DataMode                = HAL_OSPI_DATA_4_LINES;                  // 4线数据模式
    sCommand.DataDtrMode             = HAL_OSPI_DATA_DTR_DISABLE;              // 禁止数据DTR模式
    sCommand.NbData                  = NumByteToWrite;                         // 数据长度
    
    sCommand.DummyCycles             = 0;                                      // 空周期个数
    sCommand.DQSMode                 = HAL_OSPI_DQS_DISABLE;                   // 不使用DQS
    sCommand.SIOOMode                = HAL_OSPI_SIOO_INST_EVERY_CMD;           // 每次传输数据都发送指令   

    // 写使能
    if (OSPI_W25Qxx_WriteEnable() != OSPI_W25Qxx_OK)
    {
        return W25Qxx_ERROR_WriteEnable;	// 写使能失败
    }
    // 写命令  
    if (HAL_OSPI_Command(&hospi2, &sCommand, HAL_OSPI_TIMEOUT_DEFAULT_VALUE) != HAL_OK)
    {
        return W25Qxx_ERROR_TRANSMIT;		// 传输数据错误
    }   
    // 开始传输数据
    if (HAL_OSPI_Transmit(&hospi2, pBuffer, HAL_OSPI_TIMEOUT_DEFAULT_VALUE) != HAL_OK)
    {
        return W25Qxx_ERROR_TRANSMIT;		// 传输数据错误
    }
    // 使用自动轮询标志位，等待写入的结束 
    if (OSPI_W25Qxx_AutoPollingMemReady() != OSPI_W25Qxx_OK)
    {
        return W25Qxx_ERROR_AUTOPOLLING;		// 轮询等待无响应
    }
    return OSPI_W25Qxx_OK; // 写数据成功
}

/**********************************************************************************************************
*
*	函 数 名: OSPI_W25Qxx_WriteBuffer
*
*	入口参数: pBuffer 		 - 要写入的数据
*				 WriteAddr 		 - 要写入 W25Qxx 的地址
*				 NumByteToWrite - 数据长度，最大不能超过flash芯片的大小
*
*	返 回 值: OSPI_W25Qxx_OK 		     - 写数据成功
*			    W25Qxx_ERROR_WriteEnable - 写使能失败
*				 W25Qxx_ERROR_TRANSMIT	  - 传输失败
*				 W25Qxx_ERROR_AUTOPOLLING - 轮询等待无响应
*
*	函数功能: 写入数据，最大不能超过flash芯片的大小，请务必完成擦除操作
*
*	说    明: 1.Flash的写入时间和擦除时间一样，是有限定的，并不是说OSPI驱动时钟133M就可以以这个速度进行写入
*				 2.按照 W25Q64JV 数据手册给出的 页 写入参考时间，典型值为 0.4ms，最大值为3ms
*				 3.实际的写入速度可能大于0.4ms，也可能小于0.4ms
*				 4.Flash使用的时间越长，写入所需时间也会越长
*				 5.在数据写入之前，请务必完成擦除操作
*				 6.该函数移植于 stm32h743i_eval_qspi.c
*
**********************************************************************************************************/

int8_t OSPI_W25Qxx_WriteBuffer(uint8_t* pBuffer, uint32_t WriteAddr, uint32_t Size)
{	
    uint32_t end_addr, current_size, current_addr;
    uint8_t *write_data;  // 要写入的数据
    
    current_size = W25Qxx_PageSize - (WriteAddr % W25Qxx_PageSize); // 计算当前页还剩余的空间
    
    if (current_size > Size)	// 判断当前页剩余的空间是否足够写入所有数据
    {
        current_size = Size;		// 如果足够，则直接获取当前长度
    }
    
    current_addr = WriteAddr;		// 获取要写入的地址
    end_addr = WriteAddr + Size;	// 计算结束地址
    write_data = pBuffer;			// 获取要写入的数据
    
    do
    {
        // 按页写入数据
        if(OSPI_W25Qxx_WritePage(write_data, current_addr, current_size) != OSPI_W25Qxx_OK)
        {
            return W25Qxx_ERROR_TRANSMIT;
        }
    
        else // 按页写入数据成功，进行下一次写数据的准备工作
        {
            current_addr += current_size;	// 计算下一次要写入的地址
            write_data += current_size;	// 获取下一次要写入的数据存储区地址
            // 计算下一次写数据的长度
            current_size = ((current_addr + W25Qxx_PageSize) > end_addr) ? (end_addr - current_addr) : W25Qxx_PageSize;
        }
    }
    while (current_addr < end_addr) ; // 判断数据是否全部写入完毕
    
    return OSPI_W25Qxx_OK;	// 写入数据成功
}

/**********************************************************************************************************************************
*
*	函 数 名: OSPI_W25Qxx_ReadBuffer
*
*	入口参数: pBuffer 		 - 要读取的数据
*				 ReadAddr 		 - 要读取 W25Qxx 的地址
*				 NumByteToRead  - 数据长度，最大不能超过flash芯片的大小
*
*	返 回 值: OSPI_W25Qxx_OK 		     - 读数据成功
*				 W25Qxx_ERROR_TRANSMIT	  - 传输失败
*				 W25Qxx_ERROR_AUTOPOLLING - 轮询等待无响应
*
*	函数功能: 读取数据，最大不能超过flash芯片的大小
*
*	说    明: 1.Flash的读取速度取决于OSPI的通信时钟，最大不能超过133M
*				 2.这里使用的是1-4-4模式下(1线指令4线地址4线数据)，快速读取指令 Fast Read Quad I/O
*				 3.使用快速读取指令是有空周期的，具体参考W25Q64JV的手册  Fast Read Quad I/O  （0xEB）指令
*				 4.实际使用中，是否使用DMA、编译器的优化等级以及数据存储区的位置(内部 TCM SRAM 或者 AXI SRAM)都会影响读取的速度
*  FANKE
*****************************************************************************************************************FANKE************/

int8_t OSPI_W25Qxx_ReadBuffer(uint8_t* pBuffer, uint32_t ReadAddr, uint32_t NumByteToRead)
{
   OSPI_RegularCmdTypeDef  sCommand;// OSPI传输配置

   sCommand.OperationType           = HAL_OSPI_OPTYPE_COMMON_CFG;             // 通用配置
   sCommand.FlashId                 = HAL_OSPI_FLASH_ID_1;                    // flash ID

   sCommand.Instruction             = W25Qxx_CMD_FastReadQuad_IO;             // 1-4-4模式下(1线指令4线地址4线数据)，快速读取指令
   sCommand.InstructionMode         = HAL_OSPI_INSTRUCTION_1_LINE;            // 1线指令模式
   sCommand.InstructionSize         = HAL_OSPI_INSTRUCTION_8_BITS;            // 指令长度8位
   sCommand.InstructionDtrMode      = HAL_OSPI_INSTRUCTION_DTR_DISABLE;       // 禁止指令DTR模式

   sCommand.Address                 = ReadAddr;                               // 地址
   sCommand.AddressMode             = HAL_OSPI_ADDRESS_4_LINES;               // 4线地址模式
   sCommand.AddressSize             = HAL_OSPI_ADDRESS_24_BITS;               // 地址长度24位
   sCommand.AddressDtrMode          = HAL_OSPI_ADDRESS_DTR_DISABLE;           // 禁止地址DTR模式

   sCommand.AlternateBytesMode      = HAL_OSPI_ALTERNATE_BYTES_NONE;          // 无交替字节    
   sCommand.AlternateBytesDtrMode   = HAL_OSPI_ALTERNATE_BYTES_DTR_DISABLE;   // 禁止替字节DTR模式 

   sCommand.DataMode                = HAL_OSPI_DATA_4_LINES;                  // 4线数据模式
   sCommand.DataDtrMode             = HAL_OSPI_DATA_DTR_DISABLE;              // 禁止数据DTR模式 
   sCommand.NbData                  = NumByteToRead;                          // 数据长度

   sCommand.DummyCycles             = 6;                                      // 空周期个数
   sCommand.DQSMode                 = HAL_OSPI_DQS_DISABLE;                   // 不使用DQS 
   sCommand.SIOOMode                = HAL_OSPI_SIOO_INST_EVERY_CMD;           // 每次传输数据都发送指令   

 	// 写命令  
	if (HAL_OSPI_Command(&hospi2, &sCommand, HAL_OSPI_TIMEOUT_DEFAULT_VALUE) != HAL_OK)
	{
		return W25Qxx_ERROR_TRANSMIT;		// 传输数据错误
	}   
	//	接收数据
	if (HAL_OSPI_Receive(&hospi2, pBuffer, HAL_OSPI_TIMEOUT_DEFAULT_VALUE) != HAL_OK)
	{
		return W25Qxx_ERROR_TRANSMIT;		// 传输数据错误
	}
	// 使用自动轮询标志位，等待接收的结束  
	if (OSPI_W25Qxx_AutoPollingMemReady() != OSPI_W25Qxx_OK)
	{
		return W25Qxx_ERROR_AUTOPOLLING;		// 轮询等待无响应
	}
	return OSPI_W25Qxx_OK;	// 读取数据成功
}
