helu33/25-aiming-cart/chassis/Core/Src/tim.c

#include "tim.h"

TIM_HandleTypeDef htim1;
TIM_HandleTypeDef htim2;
TIM_HandleTypeDef htim3;
TIM_HandleTypeDef htim4;
TIM_HandleTypeDef htim8;

void HAL_TIM_MspPostInit(TIM_HandleTypeDef *htim);

static void pwm_channel_config(TIM_HandleTypeDef *htim, uint32_t channel)
{
    TIM_OC_InitTypeDef config = {0};
    config.OCMode = TIM_OCMODE_PWM1;
    config.Pulse = 0;
    config.OCPolarity = TIM_OCPOLARITY_HIGH;
    config.OCFastMode = TIM_OCFAST_DISABLE;
    if (HAL_TIM_PWM_ConfigChannel(htim, &config, channel) != HAL_OK) {
        Error_Handler();
    }
}

void MX_TIM1_Init(void)
{
    TIM_MasterConfigTypeDef master = {0};
    htim1.Instance = TIM1;
    htim1.Init.Prescaler = 71;
    htim1.Init.CounterMode = TIM_COUNTERMODE_UP;
    htim1.Init.Period = 19999;
    htim1.Init.ClockDivision = TIM_CLOCKDIVISION_DIV1;
    htim1.Init.RepetitionCounter = 0;
    htim1.Init.AutoReloadPreload = TIM_AUTORELOAD_PRELOAD_ENABLE;
    if (HAL_TIM_PWM_Init(&htim1) != HAL_OK) Error_Handler();
    master.MasterOutputTrigger = TIM_TRGO_RESET;
    master.MasterSlaveMode = TIM_MASTERSLAVEMODE_DISABLE;
    if (HAL_TIMEx_MasterConfigSynchronization(&htim1, &master) != HAL_OK) Error_Handler();
    pwm_channel_config(&htim1, TIM_CHANNEL_1);
    pwm_channel_config(&htim1, TIM_CHANNEL_4);
    HAL_TIM_MspPostInit(&htim1);
}

static void motor_pwm_init(TIM_HandleTypeDef *htim, TIM_TypeDef *instance)
{
    TIM_MasterConfigTypeDef master = {0};
    htim->Instance = instance;
    htim->Init.Prescaler = 0;
    htim->Init.CounterMode = TIM_COUNTERMODE_UP;
    htim->Init.Period = 899;
    htim->Init.ClockDivision = TIM_CLOCKDIVISION_DIV1;
    htim->Init.AutoReloadPreload = TIM_AUTORELOAD_PRELOAD_ENABLE;
    if (HAL_TIM_PWM_Init(htim) != HAL_OK) Error_Handler();
    master.MasterOutputTrigger = TIM_TRGO_RESET;
    master.MasterSlaveMode = TIM_MASTERSLAVEMODE_DISABLE;
    if (HAL_TIMEx_MasterConfigSynchronization(htim, &master) != HAL_OK) Error_Handler();
    pwm_channel_config(htim, TIM_CHANNEL_1);
    pwm_channel_config(htim, TIM_CHANNEL_2);
    HAL_TIM_MspPostInit(htim);
}

void MX_TIM2_Init(void) { motor_pwm_init(&htim2, TIM2); }
void MX_TIM3_Init(void) { motor_pwm_init(&htim3, TIM3); }

static void encoder_timer_init(TIM_HandleTypeDef *htim, TIM_TypeDef *instance)
{
    TIM_Encoder_InitTypeDef encoder = {0};
    TIM_MasterConfigTypeDef master = {0};
    htim->Instance = instance;
    htim->Init.Prescaler = 0;
    htim->Init.CounterMode = TIM_COUNTERMODE_UP;
    htim->Init.Period = 65535;
    htim->Init.ClockDivision = TIM_CLOCKDIVISION_DIV1;
    htim->Init.AutoReloadPreload = TIM_AUTORELOAD_PRELOAD_DISABLE;
    encoder.EncoderMode = TIM_ENCODERMODE_TI12;
    encoder.IC1Polarity = TIM_ICPOLARITY_RISING;
    encoder.IC1Selection = TIM_ICSELECTION_DIRECTTI;
    encoder.IC1Prescaler = TIM_ICPSC_DIV1;
    encoder.IC1Filter = 6;
    encoder.IC2Polarity = TIM_ICPOLARITY_RISING;
    encoder.IC2Selection = TIM_ICSELECTION_DIRECTTI;
    encoder.IC2Prescaler = TIM_ICPSC_DIV1;
    encoder.IC2Filter = 6;
    if (HAL_TIM_Encoder_Init(htim, &encoder) != HAL_OK) Error_Handler();
    master.MasterOutputTrigger = TIM_TRGO_RESET;
    master.MasterSlaveMode = TIM_MASTERSLAVEMODE_DISABLE;
    if (HAL_TIMEx_MasterConfigSynchronization(htim, &master) != HAL_OK) Error_Handler();
}

void MX_TIM4_Init(void) { encoder_timer_init(&htim4, TIM4); }
void MX_TIM8_Init(void) { encoder_timer_init(&htim8, TIM8); }
