helu33/25-aiming-cart/chassis/Core/Inc/tim.h

#ifndef __TIM_H__
#define __TIM_H__

#ifdef __cplusplus
extern "C" {
#endif

#include "main.h"

extern TIM_HandleTypeDef htim1;
extern TIM_HandleTypeDef htim2;
extern TIM_HandleTypeDef htim3;
extern TIM_HandleTypeDef htim4;
extern TIM_HandleTypeDef htim8;

void MX_TIM1_Init(void);
void MX_TIM2_Init(void);
void MX_TIM3_Init(void);
void MX_TIM4_Init(void);
void MX_TIM8_Init(void);

#ifdef __cplusplus
}
#endif
#endif
