helu33/25-aiming-cart/chassis/Core/Inc/usart.h

#ifndef __USART_H__
#define __USART_H__

#ifdef __cplusplus
extern "C" {
#endif

#include "main.h"

extern UART_HandleTypeDef huart2;
extern UART_HandleTypeDef huart4;
extern UART_HandleTypeDef huart5;

void MX_USART2_UART_Init(void);
void MX_UART4_Init(void);
void MX_UART5_Init(void);

#ifdef __cplusplus
}
#endif
#endif
