helu33/25-aiming-cart/chassis/Core/Src/gpio.c

#include "gpio.h"

void MX_GPIO_Init(void)
{
    GPIO_InitTypeDef GPIO_InitStruct = {0};

    __HAL_RCC_GPIOA_CLK_ENABLE();
    __HAL_RCC_GPIOB_CLK_ENABLE();
    __HAL_RCC_GPIOC_CLK_ENABLE();
    __HAL_RCC_GPIOD_CLK_ENABLE();

    HAL_GPIO_WritePin(GPIOB, BUZZER_Pin | RGB_R_Pin, GPIO_PIN_RESET);
    HAL_GPIO_WritePin(GPIOC, RGB_G_Pin | RGB_B_Pin, GPIO_PIN_RESET);

    GPIO_InitStruct.Pin = BUZZER_Pin | RGB_R_Pin;
    GPIO_InitStruct.Mode = GPIO_MODE_OUTPUT_PP;
    GPIO_InitStruct.Speed = GPIO_SPEED_FREQ_LOW;
    HAL_GPIO_Init(GPIOB, &GPIO_InitStruct);

    GPIO_InitStruct.Pin = RGB_G_Pin | RGB_B_Pin;
    GPIO_InitStruct.Mode = GPIO_MODE_OUTPUT_PP;
    GPIO_InitStruct.Speed = GPIO_SPEED_FREQ_LOW;
    HAL_GPIO_Init(GPIOC, &GPIO_InitStruct);
}
