helu33/25-aiming-cart/chassis/Core/Src/i2c.c

#include "i2c.h"

I2C_HandleTypeDef hi2c2;

void MX_I2C2_Init(void)
{
    hi2c2.Instance = I2C2;
    hi2c2.Init.ClockSpeed = 400000;
    hi2c2.Init.DutyCycle = I2C_DUTYCYCLE_2;
    hi2c2.Init.OwnAddress1 = 0;
    hi2c2.Init.AddressingMode = I2C_ADDRESSINGMODE_7BIT;
    hi2c2.Init.DualAddressMode = I2C_DUALADDRESS_DISABLE;
    hi2c2.Init.OwnAddress2 = 0;
    hi2c2.Init.GeneralCallMode = I2C_GENERALCALL_DISABLE;
    hi2c2.Init.NoStretchMode = I2C_NOSTRETCH_DISABLE;
    if (HAL_I2C_Init(&hi2c2) != HAL_OK) {
        Error_Handler();
    }
}
