helu33/25-aiming-cart/chassis/Core/Src/iwdg.c

#include "iwdg.h"

IWDG_HandleTypeDef hiwdg;

void MX_IWDG_Init(void)
{
    hiwdg.Instance = IWDG;
    hiwdg.Init.Prescaler = IWDG_PRESCALER_64;
    hiwdg.Init.Reload = 624U;
    if (HAL_IWDG_Init(&hiwdg) != HAL_OK) {
        Error_Handler();
    }
}
