helu33/25-aiming-cart/gimbal/Bsp/ws2812.c

//有关ws2812灯带的控制，提供了一个函数WS2812_Ctrl，可以通过传入RGB颜色值来控制灯带的颜色显示。
// 该函数将RGB颜色值转换为WS2812协议要求的数据格式，并通过SPI接口发送给灯带。函数中还包含了一些延时操作，以确保数据能够正确地传输和显示。
#include "ws2812.h"

#define WS2812_LowLevel    0xC0     // 0码
#define WS2812_HighLevel   0xF0     // 1码

void WS2812_Ctrl(uint8_t r, uint8_t g, uint8_t b)
{
    uint8_t txbuf[24];
    uint8_t res = 0;
    for (int i = 0; i < 8; i++)
    {
        txbuf[7-i]  = (((g>>i)&0x01) ? WS2812_HighLevel : WS2812_LowLevel)>>1;
        txbuf[15-i] = (((r>>i)&0x01) ? WS2812_HighLevel : WS2812_LowLevel)>>1;
        txbuf[23-i] = (((b>>i)&0x01) ? WS2812_HighLevel : WS2812_LowLevel)>>1;
    }
    HAL_SPI_Transmit(&WS2812_SPI_UNIT, &res, 0, 0xFFFF);
    while (WS2812_SPI_UNIT.State != HAL_SPI_STATE_READY);
    HAL_SPI_Transmit(&WS2812_SPI_UNIT, txbuf, 24, 0xFFFF);
    for (int i = 0; i < 100; i++)
    {
        HAL_SPI_Transmit(&WS2812_SPI_UNIT, &res, 1, 0xFFFF);
    }
}
