helu33/25-aiming-cart/vision/spot.py

"""Laser spot on the white target paper in a grayscale frame (K230 ulab or desktop numpy).

Only array operations both libraries share are used (slice, argmax, mean, clip, sum, max);
no per-pixel Python loops. The spot is the brightest blob inside the paper area, measured
as the intensity-weighted centre of its near-saturated core.
"""
try:
    from ulab import numpy as np
except ImportError:
    import numpy as np
from geometry import homography, transform

FLOAT = getattr(np, "float", None) or np.float32


def _paper_bounds(size, tape, margin):
    w, h = size
    inset = tape + margin
    return inset, inset, w - inset, h - inset


def find_spot(gray, corners, size, tape, opts):
    """Return ((x, y), "spot_ok") or (None, reason)."""
    height, width = gray.shape[0], gray.shape[1]
    w, h = size
    to_image = homography(((0, 0), (w, 0), (w, h), (0, h)), corners)
    x_min, y_min, x_max, y_max = _paper_bounds(size, tape, opts["paper_margin_mm"])
    quad = [transform(to_image, p) for p in ((x_min, y_min), (x_max, y_min), (x_max, y_max), (x_min, y_max))]
    x0 = max(0, int(min(p[0] for p in quad)) + 1)
    x1 = min(width, int(max(p[0] for p in quad)))
    y0 = max(0, int(min(p[1] for p in quad)) + 1)
    y1 = min(height, int(max(p[1] for p in quad)))
    if x1 - x0 < 8 or y1 - y0 < 8:
        return None, "spot_roi_small"

    roi = gray[y0:y1, x0:x1]
    peak_index = int(np.argmax(roi))
    py, px = peak_index // (x1 - x0), peak_index % (x1 - x0)
    peak = float(roi[py, px])
    if peak < opts["min_peak"] or peak - float(np.mean(roi)) < opts["min_contrast"]:
        return None, "spot_dim"
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
