helu33/25-aiming-cart/(notices)

Notices in the files:
chassis/Core/Src/main.c:
Copyright (c) 2026 STMicroelectronics.
All rights reserved.
This software is licensed under terms that can be found in the LICENSE file
gimbal/Core/Src/usart.c:
Copyright (c) 2024 STMicroelectronics.
